ConnorSawaya/SightSense/docs/README.md

# Docs

| Document | What it covers |
| --- | --- |
| [`../AGENTS.md`](../AGENTS.md) | Context and rules for AI coding assistants: what the project is, what is decided, what exists |
| [`PROJECT_HISTORY.md`](PROJECT_HISTORY.md) | How the plan reached its current shape, and why each change was made |
| [`DISCLOSURE.md`](DISCLOSURE.md) | Tools we used that we did not make, and any work done before the event |
| [`../contracts/MESSAGES.md`](../contracts/MESSAGES.md) | Message formats between the phone, the GX10 and the Pi |
| [`../hardware/`](../hardware/) | Printable parts and wiring |
| [`../hardware/BOM.md`](../hardware/BOM.md) | Bill of materials: everything the cane is built from |
| [`media/`](media/) | The 3D pictures in the main README (CAD renders made after the event), and in `media/photos/` the team's photos from the event |
| [3D model](https://connorsawaya.github.io/SightSense/) | The interactive model and guided tour, on GitHub Pages. It is served from the `gh-pages` branch |
