ConnorSawaya/SightSense/ios-app/README.md

# iPhone app

Captures the camera picture, LiDAR depth and position with ARKit and sends them to the GX10. Also plays beeps and speech, takes voice commands, and looks up walking routes.

Open `SightSense.xcodeproj` in Xcode. No packages to install.

## Run it

1. In Xcode, pick the SightSense target → Signing & Capabilities → choose your team. With a free Apple ID, change the bundle identifier if `com.sightsense.capture` is taken.
2. Plug in the iPhone, pick it as the destination, Run.
3. In Connection, enter the GX10 hostname or address reachable from the phone. For Tailscale, use its MagicDNS name or address; for a local router, use the host shown in the router's device list. The examples in the app are placeholders. Add `:8775` for the cane frame service (for example, `gx10.example.invalid:8775`).

Command line build, without opening Xcode:

```bash
xcodebuild -project SightSense.xcodeproj -scheme SightSense -destination 'generic/platform=iOS' \
  DEVELOPMENT_TEAM=<your team ID> -allowProvisioningUpdates build
```

## Test without the GX10

`tools/fake_gx10.py` stands in for the GX10's frame receiver on port 8765. It checks every frame against [`../contracts/MESSAGES.md`](../contracts/MESSAGES.md), prints rate, sizes and depth numbers once a second, and sends a guidance message every 2 seconds. Standard library only.

```bash
python3 tools/fake_gx10.py --save /tmp/frames   # then connect the app to <laptop IP>:8765
./tools/run_link_test.sh                         # the app's link and frame code on the Mac, against the fake
```

`run_link_test.sh` builds `GX10Link.swift` and `FrameMessage.swift` for the Mac and checks depth conversion, row padding, intrinsics scaling, the message layout, 15 frames a second, guidance received, a voice command sent, and reconnecting after the GX10 drops.

## App icon

The logo is drawn in code (`SightSense/LogoMark.swift`): a cane whose tip sends out rings in the LiDAR view's colours. The app shows it on the top bar and the connect screen. To redraw the app icon after changing it:

```bash
swiftc -parse-as-library tools/render_icon.swift SightSense/LogoMark.swift -o /tmp/render_icon \
  && /tmp/render_icon SightSense/Assets.xcassets/AppIcon.appiconset/AppIcon.png
```

In the Simulator there is no camera or LiDAR: Connect opens the link without sending frames, so guidance, speech and voice can still be tried. Launch with `-autoconnect host:port` to connect straight away.

## Files

| File | What it does |
| --- | --- |
| `Capture.swift` | ARKit session, link and location; what the screen shows |
| `FrameSender.swift` | Picks about 15 frames a second; skips a frame if the last one is still going |
| `FrameEncoder.swift` | ARKit frame → frame message (640-wide JPEG, depth, confidence, scaled intrinsics, pose) |
| `FrameMessage.swift` | The message layout and depth conversion, without ARKit, so it runs on a Mac |
| `GX10Link.swift` | WebSocket to port 8765, reconnects every second until disconnected |
| `Guidance.swift` | Parses guidance; beeps (at most once a second) and speaks (same sentence at most every 2 s). Does not speak while the user is talking; tones still play |
| `Voice.swift` | Hold-to-talk, on-device speech recognition; sends `{"text": ...}`. Also started and stopped by the cane's talk button |
| `Location.swift` | GPS and compass heading for the frame header |
| `Places.swift` | Looks a place up with Apple Maps and sends the walking route to it. Not compiled yet |

## The cane's talk button

A push button in the cane's handle does the same job as the talk button on the screen. The Pi reports it to the GX10, and the GX10 sends the phone `{"listen": true}` or `{"listen": false}` ([`../contracts/MESSAGES.md`](../contracts/MESSAGES.md)).

- `true` plays a short tone and starts listening. If the phone is already listening it stops instead, so a second click ends a command.
- `false` stops listening and sends what was heard. It comes when the button is let go after a hold.
- After a click, with no `false`, the phone stops by itself 1.5 seconds after the last new word, or after 8 seconds if it heard nothing, and in any case about 12 seconds after it started.
- A click in the 2 seconds after the phone has stopped by itself with something heard is taken as the end of that command. It plays the tone but does not start another. If the phone heard nothing, the click starts a new listen.
- While the phone is listening, from either button, it does not speak. Tones still play, the stop tone among them.

Sound, speech and touch, all written October 11 and not built yet:

- A turn can be felt as well as heard: a light tap for left and a heavy one for right, beside the stop warning that was already there.
- Settings has a **Test sounds and speech** button. It plays each tone and says its name, with no GX10 needed.
- Saying "sound check" (or typing it in Settings or on the dashboard) makes the GX10 send each tone with its name, which checks the whole path.
- The app says "Connected" when the link opens and "Connection lost" with the stop tone when it drops, as before.

**Not built yet.** This was written on a Windows laptop with no Xcode. It has not been compiled or run on a phone. Every Swift file in the app parses with a Swift grammar (tree-sitter, October 11), which rules out syntax errors only: types, names and the Apple frameworks are checked by the compiler alone. Build it and try both buttons before relying on it.

## Build order

Steps 1–7 are written. Step 8 is written in `Places.swift` but has not been compiled or run: it was written on a Windows laptop with no Xcode.

1. App shell: GX10 address field, Connect button, status line, screen kept awake.
2. ARKit session with scene depth on; show the tracking state.
3. WebSocket to `ws://<GX10>:8765` with automatic reconnect.
4. Send the frame message from [`../contracts/MESSAGES.md`](../contracts/MESSAGES.md) about 15 times a second.
5. Receive guidance: beep on STOP, speak the `speech` text.
6. Push-to-talk with on-device speech recognition; send `{"text": "..."}`.
7. Location and compass heading in every frame header.
8. Place lookup with MapKit walking directions; send the route message.

How step 8 works: the GX10 sends `{"lookup": "Safeway"}`. The phone searches Apple Maps within 5 km of where it is and takes the nearest result, so "a coffee shop" means the nearest one. It asks for walking directions and sends the route message. If it finds no place or no route it sends an empty route, and the GX10 says so. The GX10 then says the name, the distance and the time, and waits for "yes".

Step 4 is the one everything else depends on.

## Watch out for

- ARKit's picture and depth are in the sensor's landscape direction. If the phone is mounted upright, the data arrives turned 90 degrees.
- Skip a frame if the previous send has not finished. Never queue frames.
- Scale the camera intrinsics to the depth picture's size.
- Info.plist needs usage descriptions for the camera, microphone, speech recognition, location and local network, plus `NSAllowsArbitraryLoads` for `ws://` to the GX10's Tailscale address (100.x is not "local" to iOS, and `NSAllowsLocalNetworking` alongside it would cancel it).
