ConnorSawaya/SightSense/docs/media/photos/team-nametags.jpg

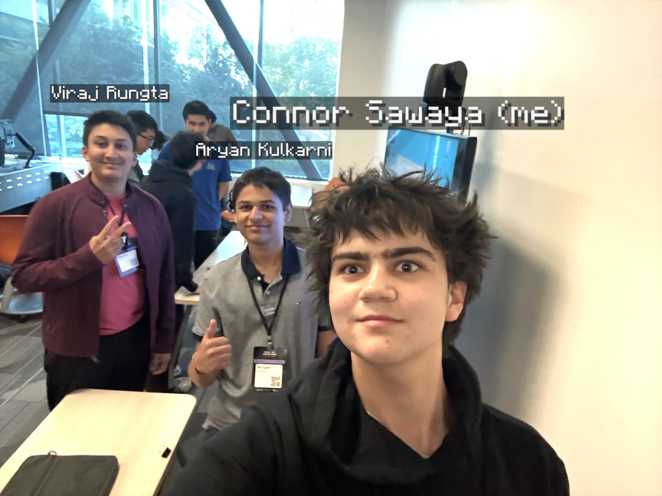
docs/media/photos/team-nametags.jpg
