ConnorSawaya/SightSense/hardware/cane-coupler/PathSense_MotorReceiver_v4_preview.png

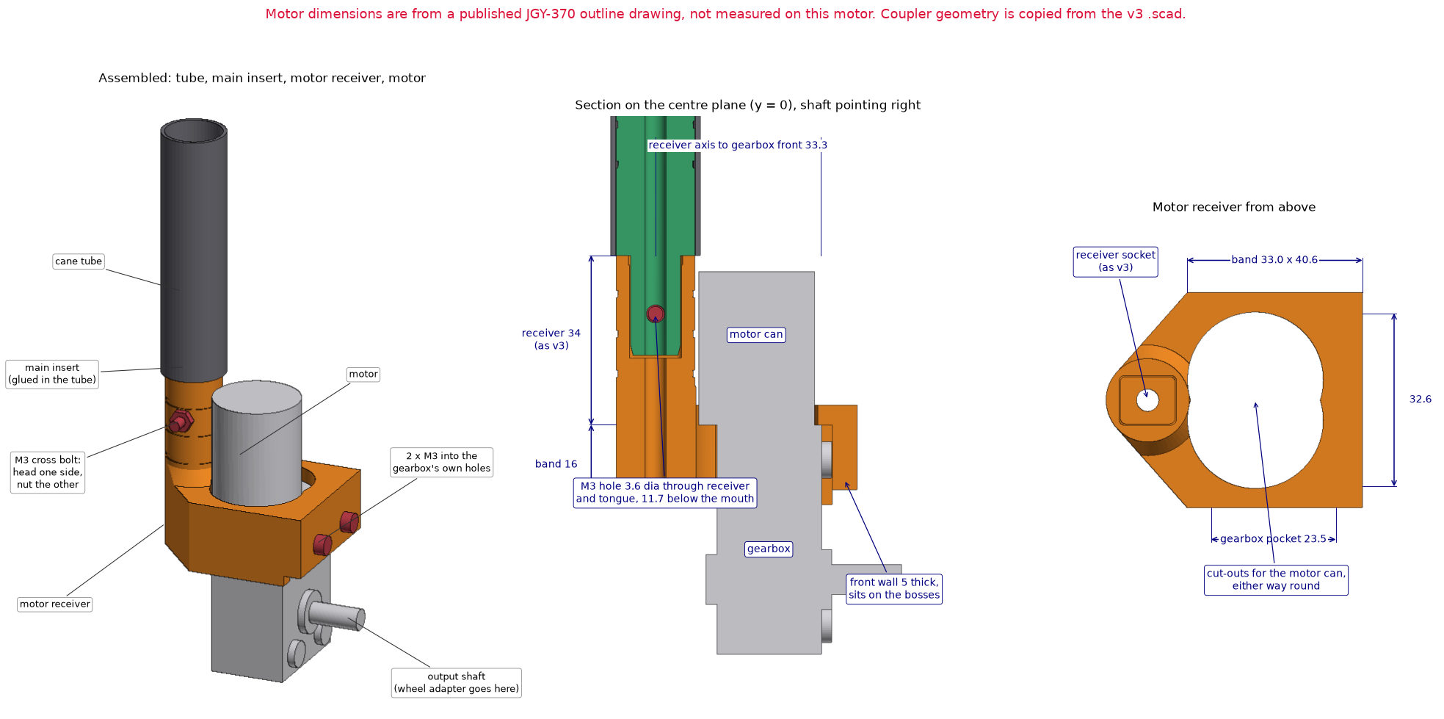
hardware/cane-coupler/PathSense_MotorReceiver_v4_preview.png
