ConnorSawaya/SightSense/hardware/handle-phone-mount/previews/2_side_view_tilt.png

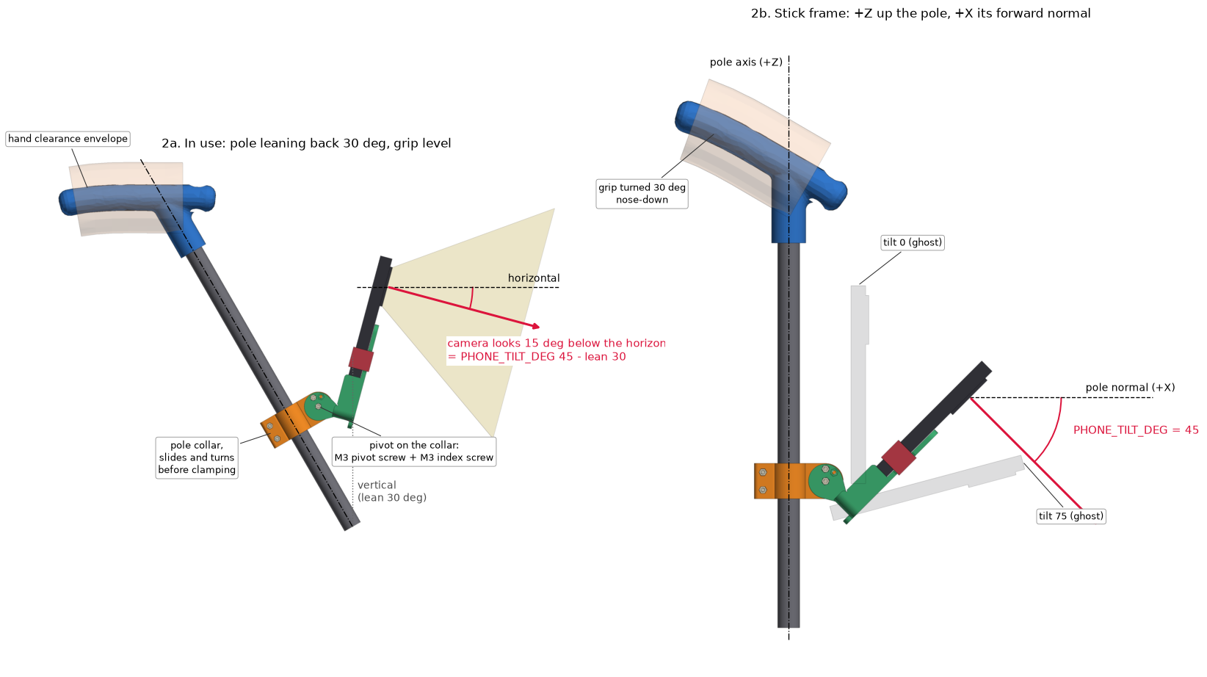
hardware/handle-phone-mount/previews/2_side_view_tilt.png
