ConnorSawaya/SightSense/hardware/handle-phone-mount/previews/3_front_view_retention.png

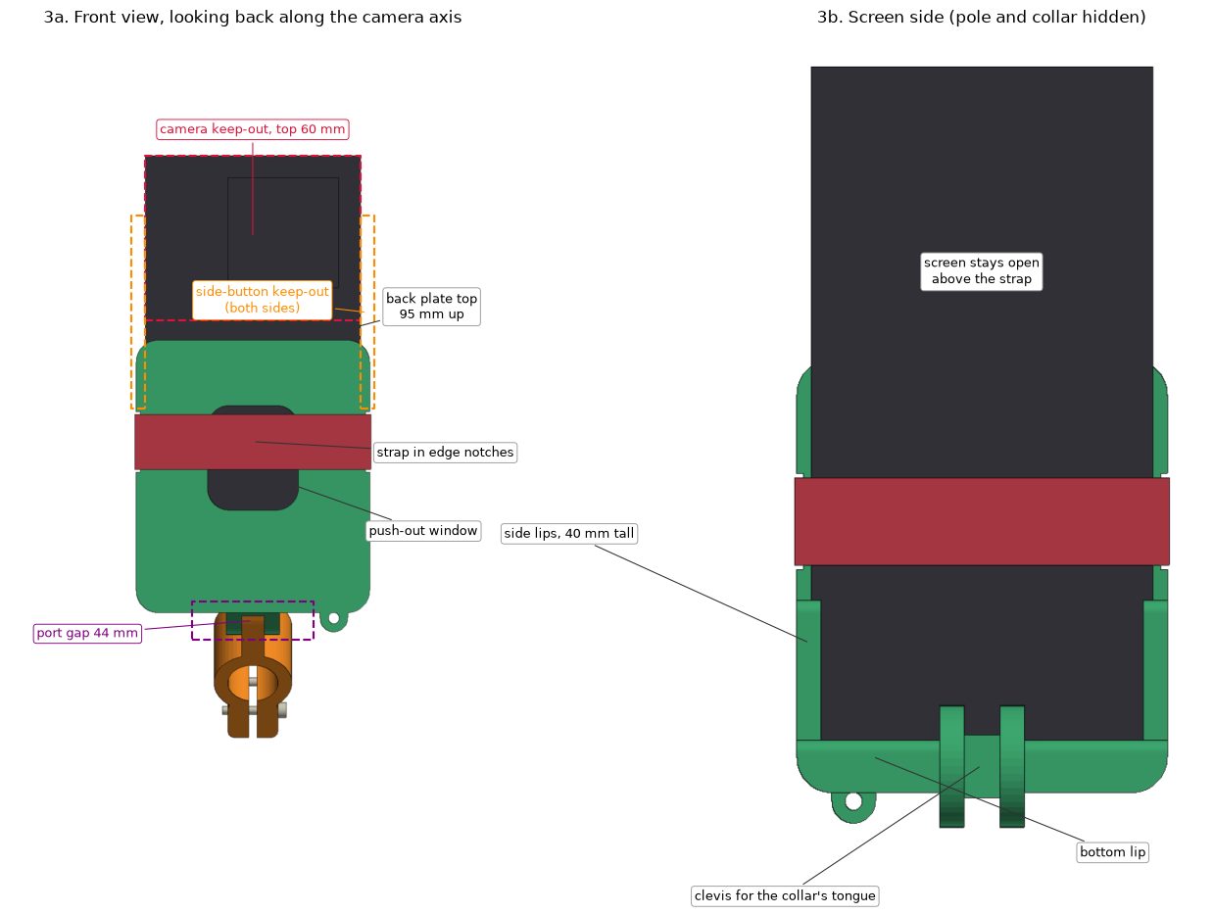
hardware/handle-phone-mount/previews/3_front_view_retention.png
