ConnorSawaya/SightSense/hardware/handle-phone-mount/previews/4_exploded.png

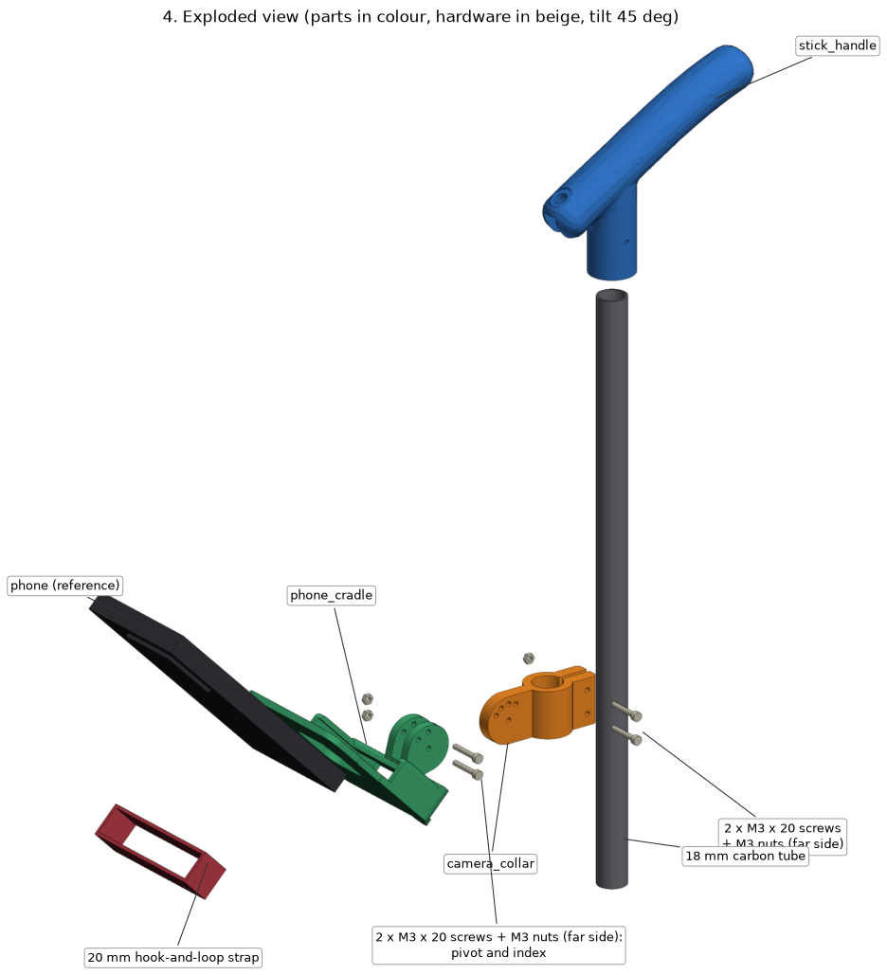
hardware/handle-phone-mount/previews/4_exploded.png
