ConnorSawaya/SightSense/hardware/handle-phone-mount/previews/5_sections_joint.png

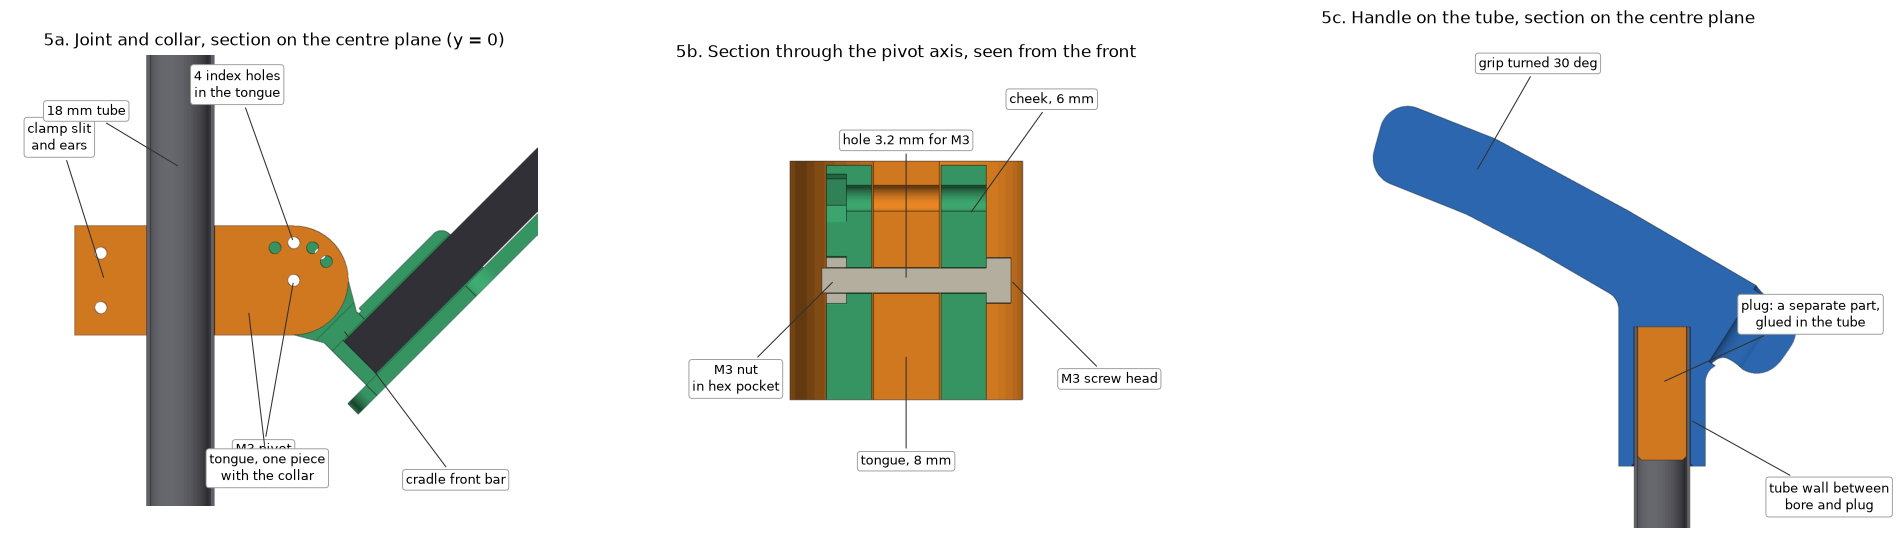
hardware/handle-phone-mount/previews/5_sections_joint.png
