ConnorSawaya/SightSense/hardware/handle-phone-mount/previews/7_dimensions_handle.png

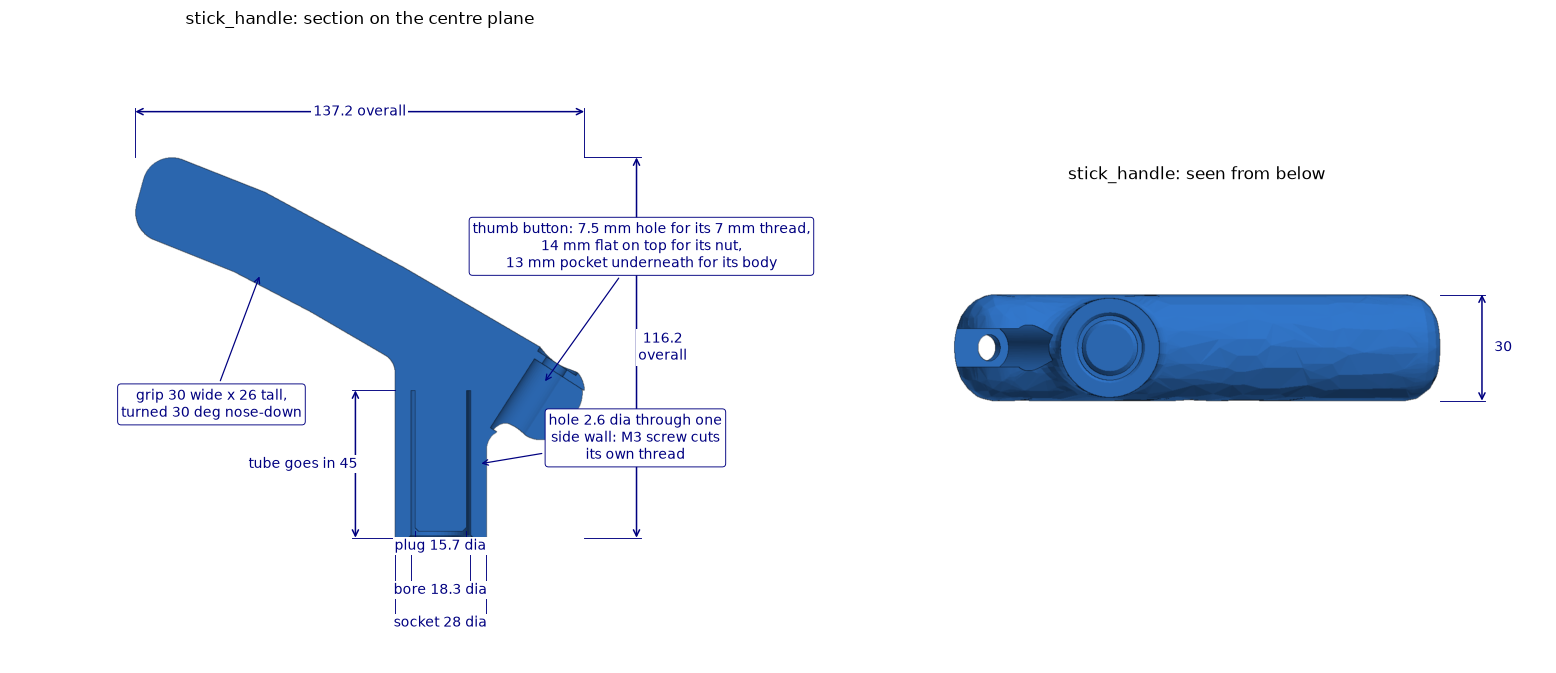
hardware/handle-phone-mount/previews/7_dimensions_handle.png
