ConnorSawaya/SightSense/hardware/handle-phone-mount/previews/8_dimensions_collar.png

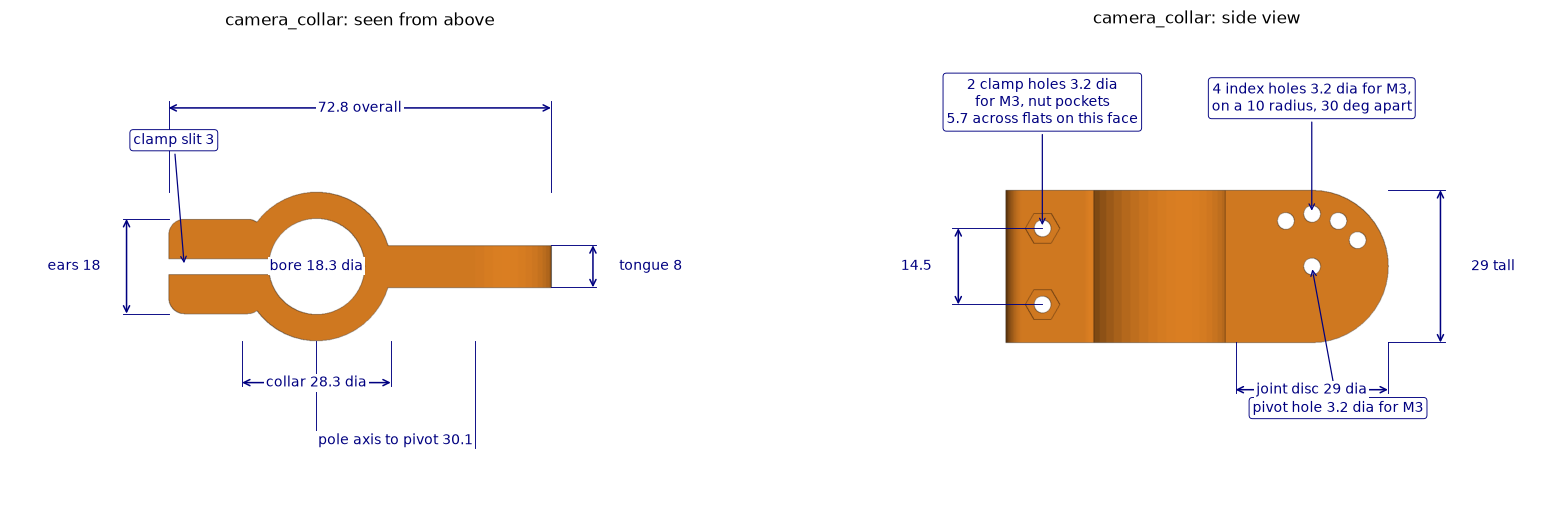
hardware/handle-phone-mount/previews/8_dimensions_collar.png
