ConnorSawaya/SightSense/hardware/handle-phone-mount/previews/9_dimensions_cradle.png

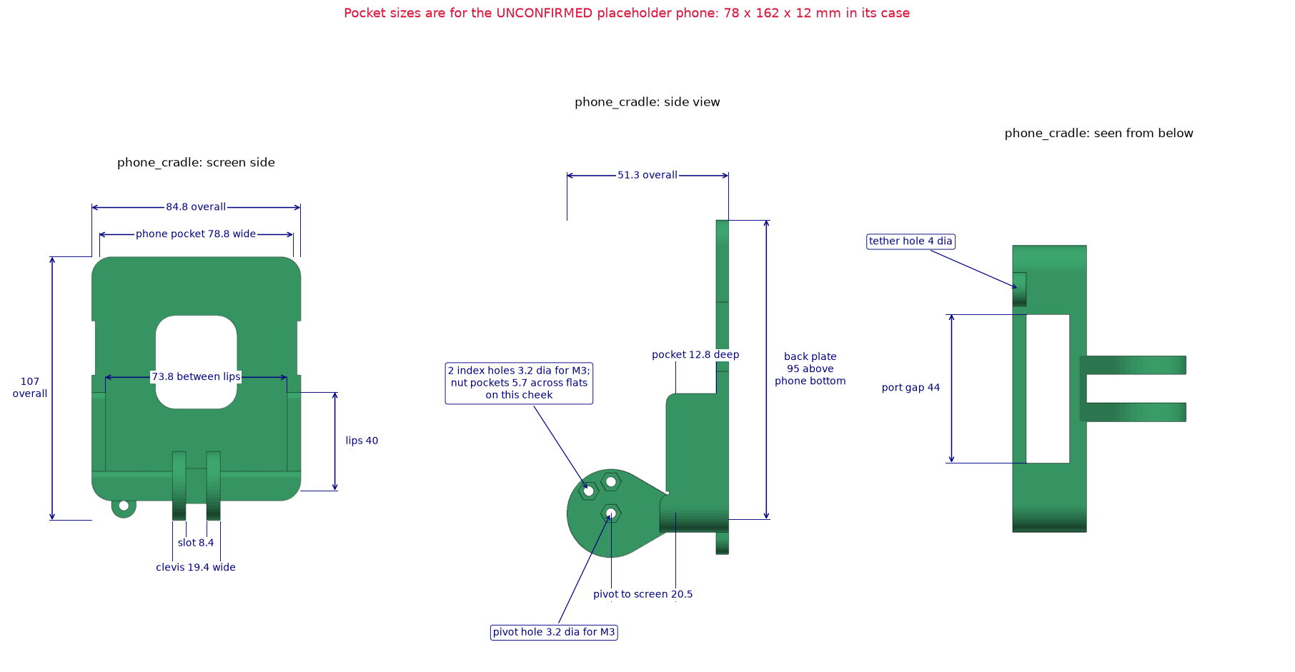
hardware/handle-phone-mount/previews/9_dimensions_cradle.png
