ConnorSawaya/SightSense/hardware/handle-phone-mount/export/assembly.step

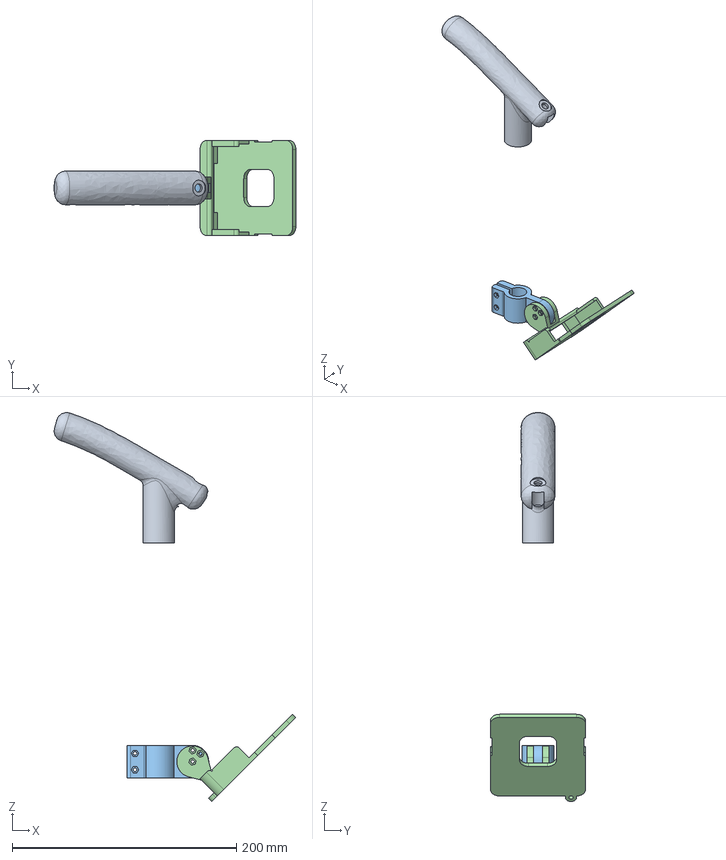
[picture p18: CAD file, 2026-10-11]
hardware/handle-phone-mount/export/assembly.step
215.6 x 84.8 x 346.8 mm
stick_handle
socket_plug
camera_collar
phone_cradle
