ConnorSawaya/SightSense/hardware/cane-coupler/PathSense_Keyed_ShockCord_Main_v3.stl

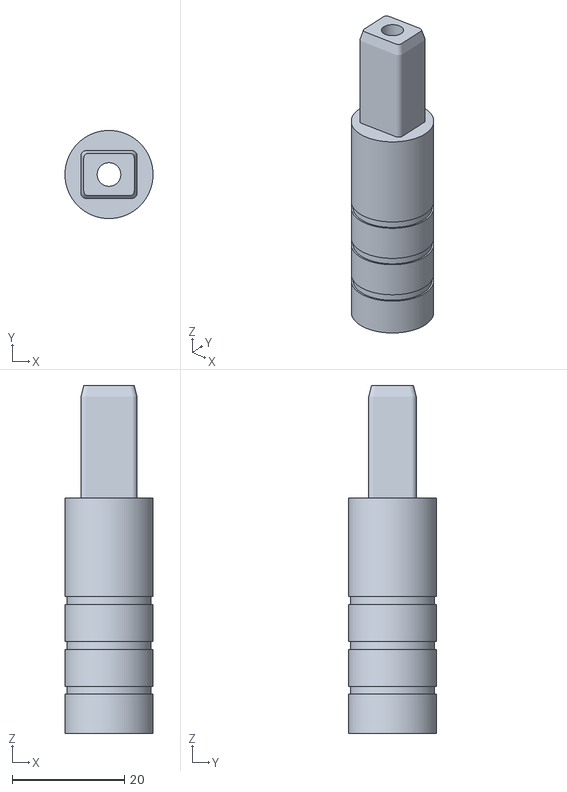
[picture p19: CAD file, 2026-10-10]
hardware/cane-coupler/PathSense_Keyed_ShockCord_Main_v3.stl
15.7 x 15.7 x 62.0
