ConnorSawaya/SightSense/hardware/cane-coupler/PathSense_Keyed_ShockCord_MotorReceiver_v4.step

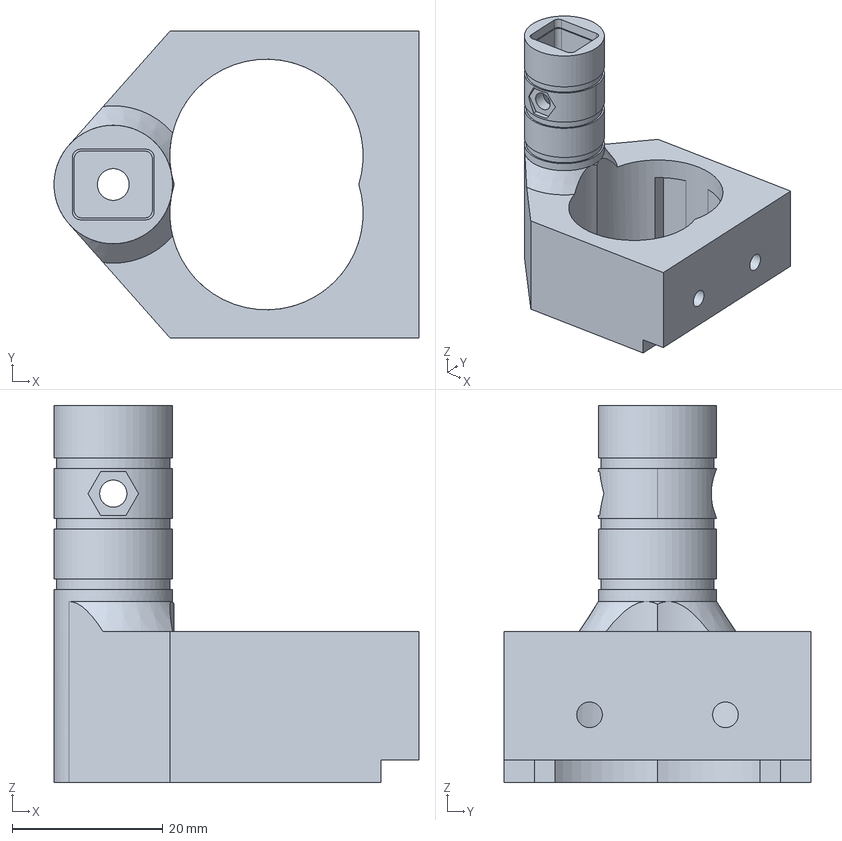
[picture p20: CAD file, 2026-10-11]
hardware/cane-coupler/PathSense_Keyed_ShockCord_MotorReceiver_v4.step
48.3 x 40.6 x 50.0 mm
