ConnorSawaya/SightSense/hardware/electronics-mount/export/electronics_mount_pi_half.step

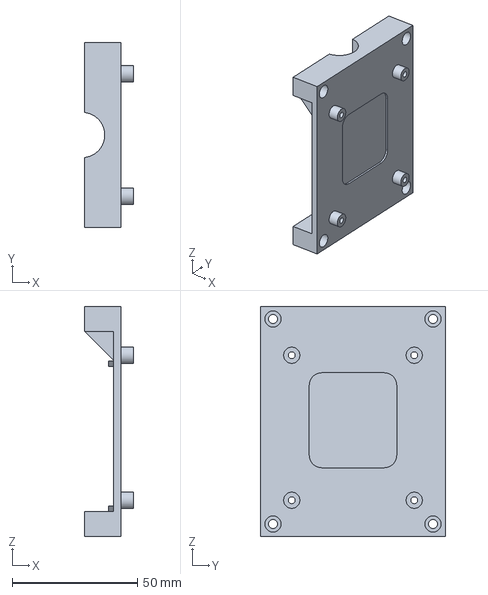
[picture p21: CAD file, 2026-10-11]
hardware/electronics-mount/export/electronics_mount_pi_half.step
19.5 x 74.0 x 92.0 mm
