ConnorSawaya/SightSense/hardware/motor-mount-2/export/motor_mount_2_motor_fit_test.step

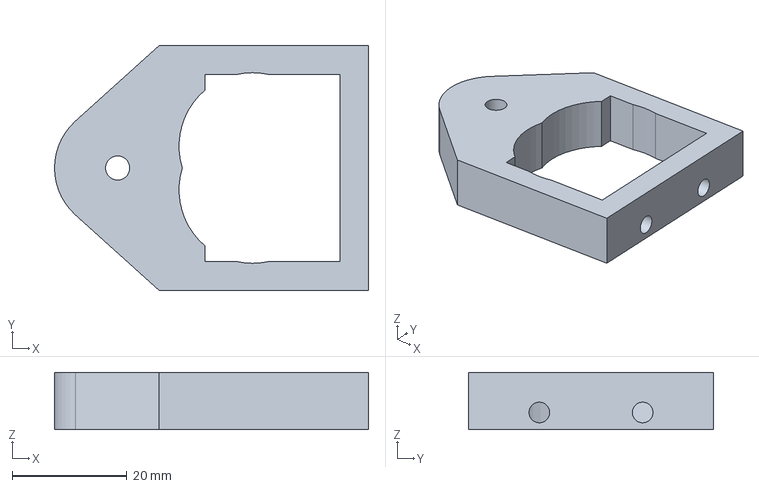
[picture p22: CAD file, 2026-10-11]
hardware/motor-mount-2/export/motor_mount_2_motor_fit_test.step
54.7 x 42.6 x 10.0 mm
