ConnorSawaya/SightSense/hardware/wheel-adapter/export/wheel_cap.stl

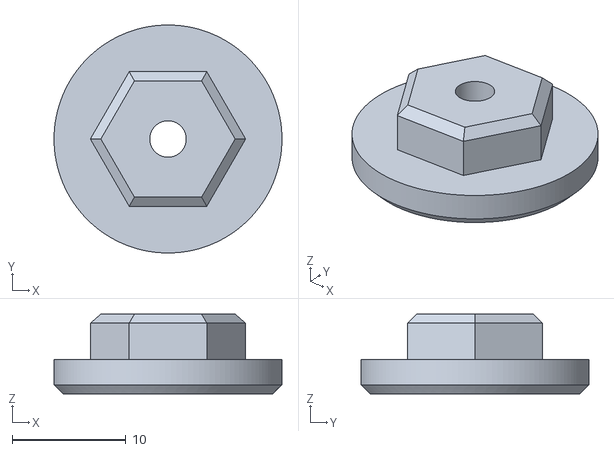
[picture p23: CAD file, 2026-10-10]
hardware/wheel-adapter/export/wheel_cap.stl
20.0 x 20.0 x 7.00
