ConnorSawaya/SightSense/hardware/cane-coupler/PathSense_Keyed_ShockCord_Receiver_v3.stl

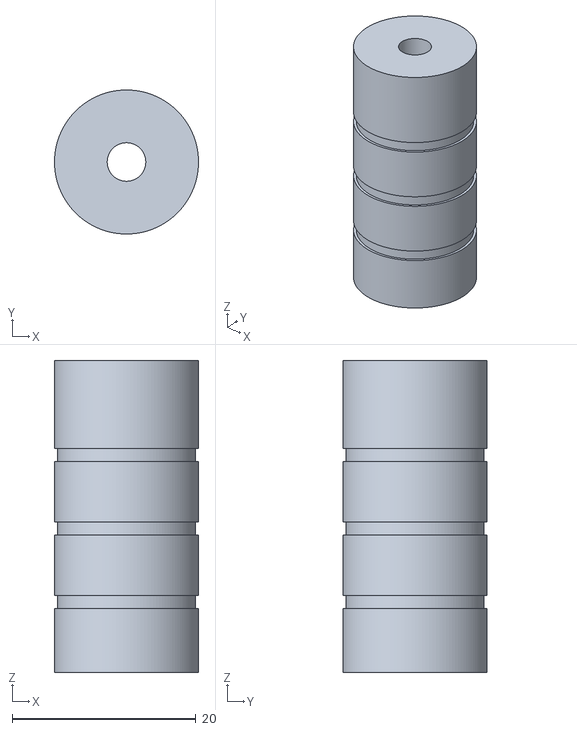
[picture p24: CAD file, 2026-10-10]
hardware/cane-coupler/PathSense_Keyed_ShockCord_Receiver_v3.stl
15.7 x 15.7 x 34.0
