ConnorSawaya/SightSense/hardware/handle-phone-mount/export/stick_handle.step

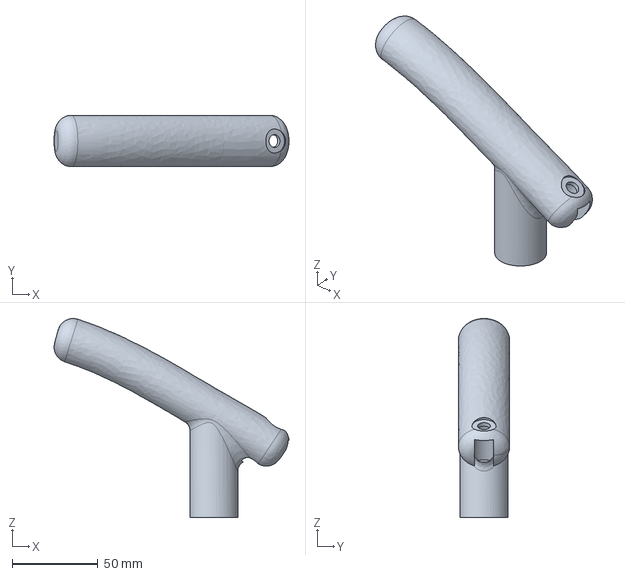
[picture p25: CAD file, 2026-10-11]
hardware/handle-phone-mount/export/stick_handle.step
137.2 x 30.0 x 116.2 mm
