ConnorSawaya/SightSense/hardware/motor-mount-2/export/motor_mount_2.stl

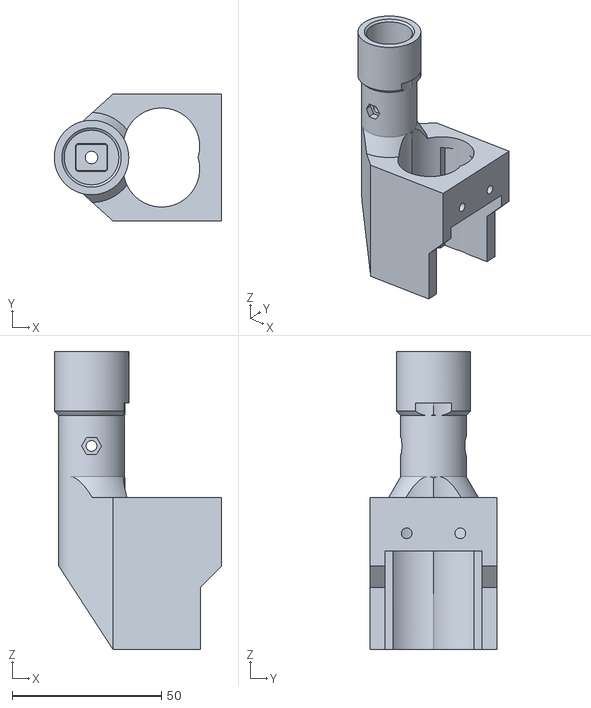
[picture p26: CAD file, 2026-10-11]
hardware/motor-mount-2/export/motor_mount_2.stl
56.2 x 42.6 x 100.0
