ConnorSawaya/SightSense/hardware/wheel-adapter/export/wheel_adapter.step

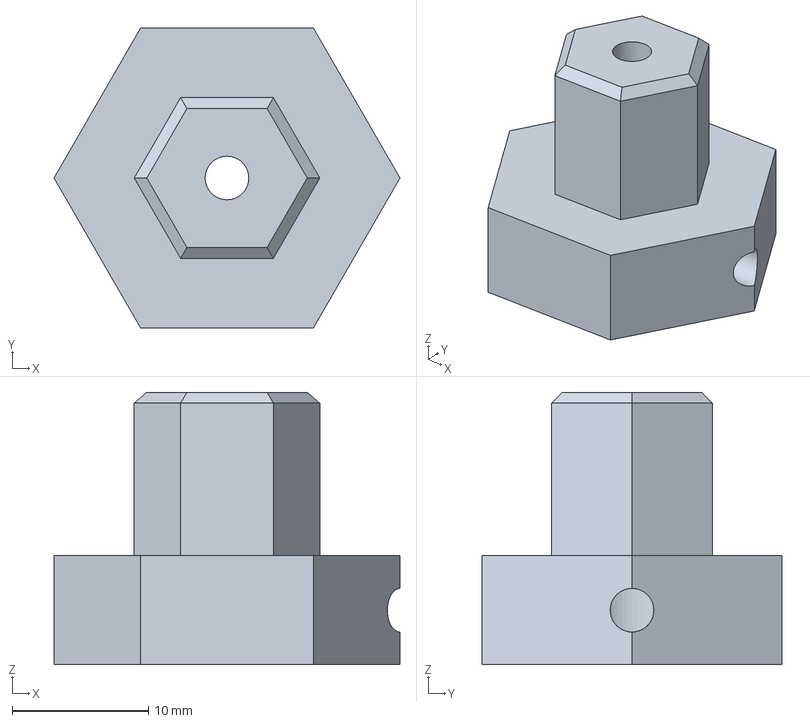
[picture p27: CAD file, 2026-10-10]
hardware/wheel-adapter/export/wheel_adapter.step
25.4 x 22.0 x 20.0 mm
