ConnorSawaya/SightSense/hardware/handle-phone-mount/export/cradle_fit_test.step

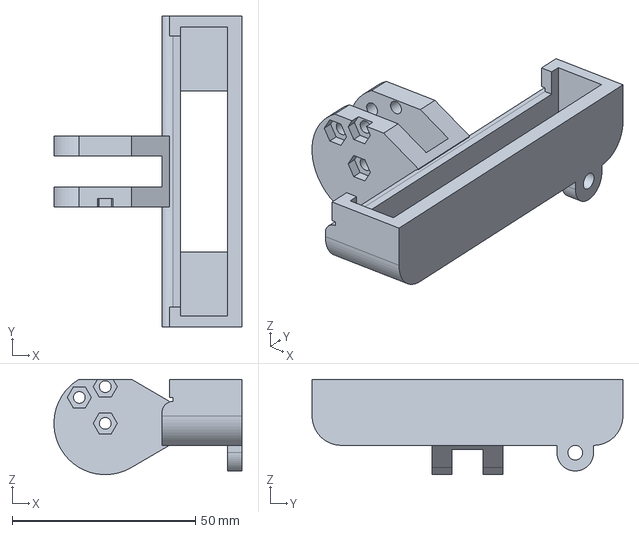
[picture p28: CAD file, 2026-10-10]
hardware/handle-phone-mount/export/cradle_fit_test.step
51.3 x 84.8 x 26.0 mm
