ConnorSawaya/SightSense/hardware/wheel-adapter/export/wheel_adapter_fit_test.step

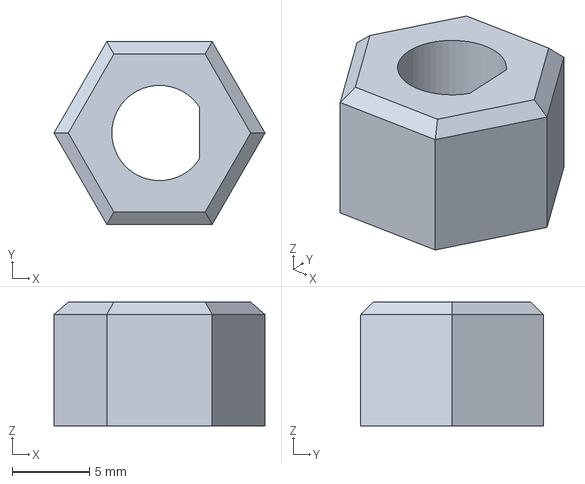
[picture p29: CAD file, 2026-10-10]
hardware/wheel-adapter/export/wheel_adapter_fit_test.step
13.6 x 11.8 x 8.00 mm
