ConnorSawaya/SightSense/hardware/handle-phone-mount/export/camera_collar.step

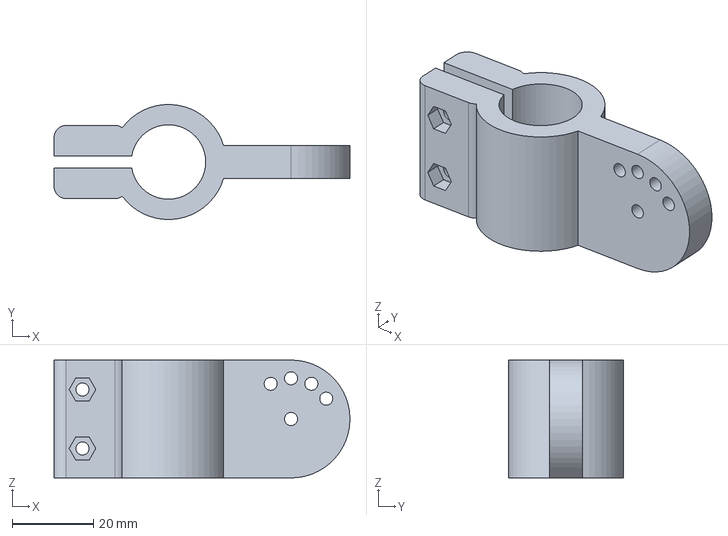
[picture p30: CAD file, 2026-10-10]
hardware/handle-phone-mount/export/camera_collar.step
72.8 x 28.3 x 29.0 mm
