ConnorSawaya/SightSense/hardware/handle-phone-mount/export/phone_cradle.step

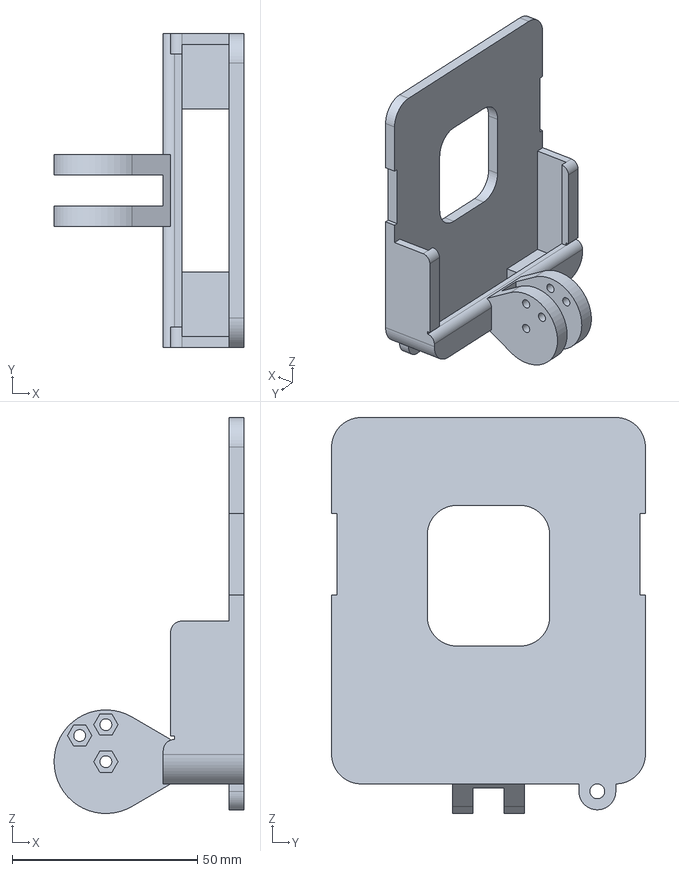
[picture p31: CAD file, 2026-10-10]
hardware/handle-phone-mount/export/phone_cradle.step
51.3 x 84.8 x 107.0 mm
