ConnorSawaya/SightSense/hardware/handle-phone-mount/export/handle_fit_test.step

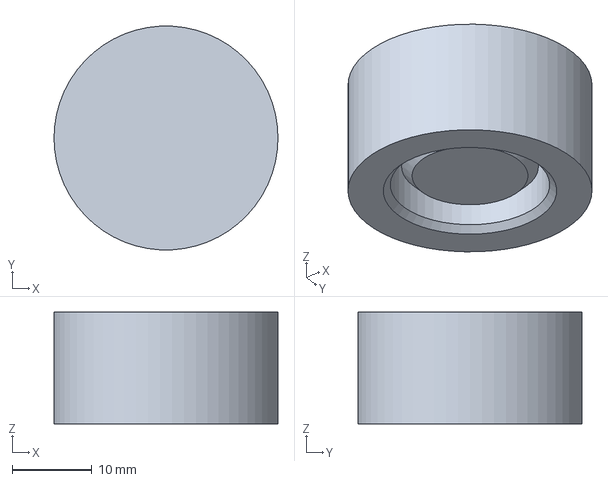
[picture p32: CAD file, 2026-10-10]
hardware/handle-phone-mount/export/handle_fit_test.step
28.0 x 28.0 x 14.0 mm
