ConnorSawaya/SightSense/(list of files, cad)

Other CAD files:
hardware/cane-coupler/PathSense_Keyed_ShockCord_MotorReceiver_v4.stl
hardware/electronics-mount/export/electronics_mount_pi_half.stl
hardware/handle-phone-mount/export/camera_collar.stl
hardware/handle-phone-mount/export/cradle_fit_test.stl
hardware/handle-phone-mount/export/handle_fit_test.stl
hardware/handle-phone-mount/export/phone_cradle.stl
hardware/handle-phone-mount/export/stick_handle.stl
hardware/wheel-adapter/export/wheel_adapter.stl
hardware/wheel-adapter/export/wheel_adapter_fit_test.stl
