ConnorSawaya/SightSense/hardware/assembly/assembly_viewer.html

# SightSense cane assembly

Zoom +Zoom −Lean pole: on

Parts

Printed parts onlyShow all

About this model

Tube drawn 900 mm long; it is cut to suit the user. The wheel and the phone are stand-ins: their sizes are not measured. Motor sizes are from a published drawing. Research prototype: nothing here has been printed or load tested.

Drag to rotate · scroll to zoom · right-drag or Shift-drag to pan
