ConnorSawaya/SightSense/hardware/handle-phone-mount/previews/6_print_orientations.png

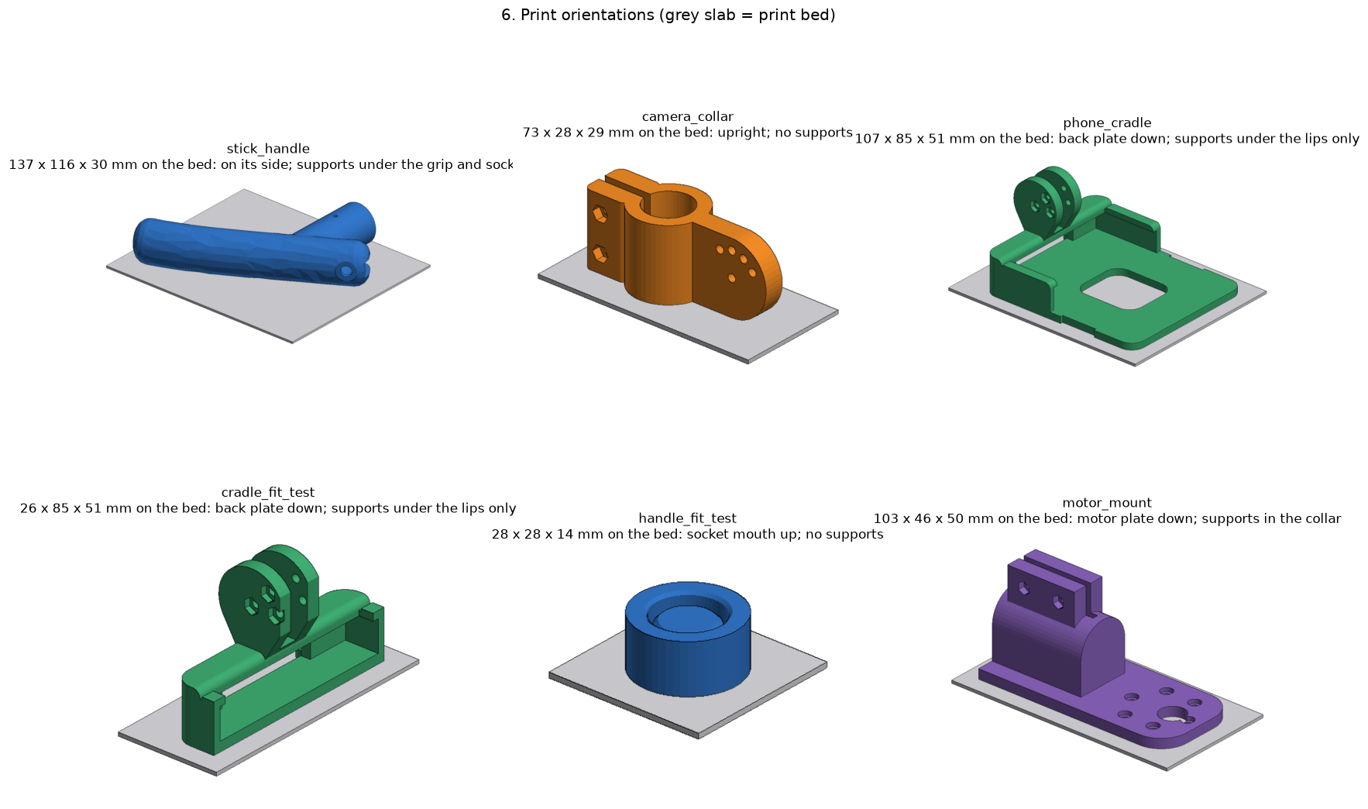
hardware/handle-phone-mount/previews/6_print_orientations.png
