ConnorSawaya/SightSense/(commit log)

2026-10-10 Add cane coupler files and set up the repo structure
    Add the keyed shock-cord coupler for the 18 mm carbon-fibre tube cane
    (two STL parts and the OpenSCAD source) under hardware/cane-coupler,
    with a README giving its dimensions, print notes and assembly steps.
    Lay out the repository: contracts (message formats), ios-app, gx10, pi,
    hardware (wiring and part conventions) and docs (handbook link and a
    disclosure file). Each folder has a README describing what goes there.
2026-10-10 Add project context and history for AI assistants
    AGENTS.md gives an AI coding assistant what it needs before touching
    the repo: what the project is, current status, the rules that must not
    be broken, machines and addresses, decisions made, the algorithms with
    their starting numbers, known traps, priorities and checkpoints.
    CLAUDE.md imports it so Claude Code loads it automatically.
    docs/PROJECT_HISTORY.md records how the plan changed and why, from the
    first wearable idea to the cane, including ideas that were dropped.
2026-10-10 Add tilted handle and pole-mounted phone mount
    New hardware/handle-phone-mount folder: build123d source, STL and STEP
    exports for the handle, pole collar and phone cradle, two fit-test
    pieces, review images and a 3D viewer page.
    The cradle is sized for a placeholder phone and is not ready to print.
    Geometric checks only; nothing has been printed or load tested.
    docs/DISCLOSURE.md records that the script was started about an hour
    before hacking opened.
2026-10-10 Note that the oversize phone cradle is intentional and strapped
    The team will print the cradle at its generic phone size and hold the
    iPhone with straps, so the docs no longer say it is not ready to print.
2026-10-10 Add the Pi motor controller, tested on a simulated wheel
    The steering rules from pi/README.md: three positions found with limit
    switches, 25% power cap, 0.4 s limit per move, driver off after 0.4 s
    without a command, home to centre at start and after the driver has been
    off.
    It can take commands from the GX10's WebSocket port, from the keyboard,
    or from fake_gx10.py, and can run on a simulated wheel with no GPIO.
    Tested on a laptop only: 29 unit tests on the simulated wheel and
    gpiozero's mock pins, plus live runs with typed commands and with the
    fake GX10. Not yet run on the Pi or with a real motor.
    Adds one dependency on the Pi: python3-websockets.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
2026-10-10 Add printed wheel adapter for the JGY-370 D-shaft
    New hardware/wheel-adapter folder: build123d source, STL and STEP
    exports, a fit-test piece and a dimensioned drawing. The hub puts the
    omni wheel's hex socket onto the gearmotor's 6 mm D-shaft.
    The hex size, shaft flat and shaft length are estimates, so the README
    says to print the fit test first. Geometric checks only; nothing has
    been printed or load tested.
2026-10-10 Add the navigator: voice commands, guide to an object, route follower
    gx10/navigator/ turns voice text into commands, guides to an object found
    by vlm.find (distance from the LiDAR depth in the box, target kept as an
    ARKit world point), and follows a MapKit route from GPS and heading. It
    only outputs a desired bearing; the obstacle check decides what is clear.
    Standard library only. 25 tests on fake frames; live check with
    qwen3.6:35b passes on the test pictures. Also defaults vlm to
    qwen3.6:35b while Qwen3-VL downloads.
2026-10-10 Add the YOLO detector and feed its boxes to the object guide
    gx10/detector/ runs YOLO26s with PyTorch in a project-folder virtual
    environment (Docker needs a group change on the borrowed GX10). 5.9 ms a
    frame including JPEG decode; finds the bus, people and apples in the test
    pictures and nothing in the empty room. navigator.check_live --yolo
    confirms the apple in 0.09 s instead of 1.3-1.8 s. TensorRT export is
    written but not run. Weights are not committed (*.pt is ignored).
2026-10-10 Add the iPhone app: LiDAR capture, frame sending, guidance, voice, location
    SwiftUI + ARKit app in ios-app/ following contracts/MESSAGES.md. Shows LiDAR
    depth only; the camera JPEG is still sent for the vision-language model.
    Tracking words match gx10/navigator (notAvailable, relocalizing).
    tools/fake_gx10.py checks frames against the contract and sends test guidance;
    tools/run_link_test.sh runs the app's link and message code on a Mac against it.
    Tested on a Mac, in the Simulator, and installed on an iPhone 15 Pro.
2026-10-10 Record the first run of the motor controller on the Pi
    On the Raspberry Pi 5 (Raspberry Pi OS Lite 64-bit, 2026-10-06): the 29
    unit tests pass, the simulated wheel follows typed commands, and the
    real GPIO pins open with the switches reading "none pressed". No motor
    or switches were connected, so nothing was driven.
2026-10-10 Rework the wheel adapter for the measured wheel
    The hub now has a 12 mm hex and a 10 mm round pilot, both from the
    team's measurements of the wheel. The wheel screw's nut moved to the
    far side of the wheel, where it can be reached, and a printed cap was
    added for it to tighten against. No slot is cut into the hex any more.
    The bore is round where the shaft has no flat. Shaft sizes are checked
    against a published JGY-370 outline drawing, not measured on the motor.
2026-10-10 Add v4 coupler parts: M3 cross bolt and motor receiver
    The v4 main insert and receiver keep the v3 coupler geometry (rebuilt
    from the .scad; volumes agree with the v3 STLs to within 0.06%) and
    gain one M3 hole through the receiver and the tongue.
    The v4 receiver also stands on a band that holds the JGY-370 gearmotor
    beside it, fixed with two M3 screws into the gearbox's own holes.
    Motor sizes come from a published outline drawing, not from measuring
    this motor. Geometric checks only; nothing has been printed.
    The v3 files are unchanged.
2026-10-10 Allow ws:// to the GX10's Tailscale address; show full link errors
    iOS does not count 100.x Tailscale addresses as local, so NSAllowsLocalNetworking
    blocked the WebSocket. Tested: real iPhone 15 Pro frames reach the GX10 over Tailscale.
2026-10-10 Add a first frame service and obstacle check
    gx10/ingest/server.py takes the phone frames on 8765 (newest only), turns
    the picture upright from the pose for YOLO and the vision model, runs the
    navigator and the 7-heading obstacle check from AGENTS.md, and sends
    guidance to the phone and a command to the Pi on 8766 every frame.
    gx10/planner/ is the depth-only obstacle check with numpy; unknown and
    too-close readings count as blocked. Tested on ray-cast scenes and a fake
    phone walking at a wall: 15 fps, 10 ms on the GX10, STOP at 2.27 m.
    First versions, to get the loop going before the 5 PM checkpoint.
2026-10-10 Redesign the iPhone app: full-screen LiDAR HUD with Liquid Glass
    - LiDAR viewport with reticle and large centre distance over a blurred depth backdrop
    - Guidance pill tinted by state; red edge glow and haptic on STOP
    - Glass dock: hold to talk, Describe and Read quick commands for gx10/navigator
    - Settings sheet from the top-left gear: address, presets (Tailscale, team router),
    recent addresses, connect/disconnect, full link status and diagnostics, typed commands
    - Microphone and speech permission asked on first use, not at launch
    - Minimum iOS 26 for Liquid Glass; Simulator shows a synthetic depth scene
2026-10-10 Add the dashboard and the network round trip
    gx10/dashboard/ serves a page on port 8000 from the frame service: the
    upright picture with YOLO boxes, colour depth, the command and state,
    clearance per heading, a text box that works like a voice command,
    frames per second, GX10 time, WebSocket round trip, GPU use. Checked in a
    browser over Tailscale with the fake phone running.
2026-10-10 Document the wiring by header pin, the Pi's set-up and the network change
    - hardware/wiring.md: header pin numbers, how to find them, which switch
    legs to use, the order to wire in, and what damages the Pi.
    - pi/README.md: the team's Pi (OS, bootloader, login, what is installed),
    power and fan notes, and how its bootloader error was fixed.
    - docs/PROJECT_HISTORY.md: no router at the venue, venue Wi-Fi problems,
    the phone hotspot, and the Pi's first start.
    - AGENTS.md: the Pi's real network, and three new known traps.
    - docs/DISCLOSURE.md: Raspberry Pi OS, Imager and the bootloader recovery
    files; the SD card was written the evening before the event.
    Nothing in the wiring has been bu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
2026-10-11 Switch the wiring and the controller to the IBT-2 driver the team has
    The motor driver is an IBT-2 (BTS7960) board, not the L298N the plan
    assumed. It takes two enable pins and a PWM pin for each direction.
    - pi/hardware.py: enables on GPIO18 and GPIO25, power on GPIO23 (RPWM)
    or GPIO24 (LPWM). Driver off is both enables low and no PWM.
    - pi/test_steering.py: pin tests for the new pin set, and a check that
    both directions are never powered together. 30 tests.
    - hardware/wiring.md: the real parts, the power split at the screw
    adapter, the converter that powers the Pi, and the header pins.
    - AGENTS.md, README.md, hardware/README.md, pi/README.md,
    docs/PROJECT_HISTORY.md: L298N replace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
2026-10-11 Cut the app's heat: 30 fps camera, lower send rate when hot, lighter screen
    The phone reached thermal state 'serious' within minutes of streaming.
    - ARKit ran at its default 60 fps although only 15 frames a second are sent; pick
    the lowest-rate 4:3 format (30 fps) so the camera, LiDAR and tracking do half the work
    - Send 15 fps normally, 8 when 'serious', 4 when 'critical'; the screen says so
    - JPEG quality 0.6 -> 0.4 (pictures were ~67 KB)
    - Depth preview 5 pictures a second (2 when hot) instead of 10
    - Static backdrop instead of a live full-screen blur of the depth picture
    - Settings show the camera format and the phone's heat
2026-10-11 Hold the phone's guidance state steady instead of flickering
    Holding the iPhone still about 2.5 m from something flipped CLEAR/CAUTION every few
    frames: the state was worked out fresh each frame against USABLE_M, and each flip
    replayed the caution earcon. planner/state.py adds hysteresis (back to CLEAR only past
    2.8 m, for 5 frames) and a 2-frame hold for other changes. STOP is never delayed.
    Tested: planner.test_state (9 new), all 55 gx10 unit tests, and ingest.fake_phone's
    wall walk on spare ports on the GX10 (STOP at the same frame and distance as before).
2026-10-11 Revise the wheel adapter after the first test print
    The first print's 3.2 mm holes were too tight for M3 screws and the
    motor bore did not fit well. The model also had a fault: the bore's
    flat ran to the bottom, so the wheel screw's head could not sit
    centred there.
    - Screw holes are 3.6 mm.
    - The bore follows the published shaft drawing and is D-shaped from
    its mouth, with a round pocket and passage for the wheel screw's
    head. The adapter now starts where the shaft's flat starts.
    - The collar is 28 mm across flats, with the clamp screw's head sunk
    into it.
    - The nut slot is 3.2 mm thick and sits 3.75 mm out from the bore,
    with a flat wall between them.
    - Parts are exported standing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
2026-10-11 Let Qwen understand voice commands the rules miss; answer status and questions
    Rules in navigator/commands.py stay first (instant). A sentence they do not understand
    goes to vlm.interpret(), text only, which picks one of the same commands or:
    - status ('am I going the right way', 'how far is it'): answered from the navigator's
    own numbers, never by the model; the common phrasings are also a rule now
    - question: answered from the picture by vlm.ask(), told never to give distances or say
    whether it is safe; any distance in the reply is replaced
    The model never steers. 'Am I going the right way' had come back 'unknown' three times
    in the iPhone test on October 10.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
2026-10-11 Hold CLEAR back for 1 s and judge by the nearest reading of the last half second
    On the October 10 walk the reading ahead jumped between about 2.2 and 4.5 m from frame
    to frame, and with a 5-frame hold the phone still flipped CLEAR/CAUTION five times in
    4 s. Never slower to say CAUTION or STOP; only slower to say CLEAR.
2026-10-11 Answer "am I going the right way", path questions and free questions
    The first iPhone test said "Am I going the right way" three times and got
    "didn't catch that". Now:
    - status ("am I going the right way", "how far is it", "which way"):
    the navigator says the direction and LiDAR distance to the object, or
    on/off the route and metres to go;
    - path ("is the path clear", "is it safe", "anything in front of me"):
    answered by the frame service from this frame's obstacle check only,
    never the model, and never called safe;
    - any other question goes to vlm.ask, told not to give distances or judge
    safety; a sentence with a distance in it is dropped;
    - anything else gets a hint listing comm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
2026-10-11 Pass the model's voice understanding through the frame service; ask with the whole sentence
    - ingest.server's UprightVLM now passes interpret() and ask() through (ask turns the
    picture upright first); without it every sentence the rules missed stayed 'unknown'
    - Picture questions use the whole sentence: the model shortened them ('colour')
    - interpret prompt: separate yes and no (the model copied 'yes or no' as the command),
    and describe only for general requests
    - 'how far away is the wall' is a question, not trip status
    Tested on the GX10 with qwen3-vl:30b-a3b-instruct: 14/15 phrasings read right in
    0.33-0.47 s; replaying the iPhone recording 20261010-172549 through the service on spar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
2026-10-11 Let the model place voice commands the rules cannot
    Rules stay first. A sentence they cannot place, or a request worded as a question
    ('could you point me toward the exit', which the rules sent to the picture), goes to
    vlm.interpret(), text only, which picks one of the same commands (object, place,
    describe, read, status, path, ask, yes, no, cancel). It never steers; 'path' is still
    answered from depth and 'status' by the navigator. The frame service passes it through.
    Tested on the GX10 with qwen3-vl:30b-a3b-instruct through the frame service on spare
    ports, replaying iPhone recording 20261010-172549: 5 odd phrasings placed right in
    0.38-0.47 s, each followed by the right action and speech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
2026-10-11 Status: real phone frames reached the GX10 frame service; heat fix merged
2026-10-11 Record where each IBT-2 pin physically sits, and why VCC is on 3.3 V
    The header's two rows and the screw terminal order, checked against the
    board's user guide and a photo of the team's board. Notes that the
    3.3 V choice for VCC is reasoned from the buffer chip and not yet tried.
2026-10-11 Add a thumb button to the handle's nose
    The nose now runs level for about 50 mm ahead of the pole and carries a
    panel-mount push button 34 mm from the pole axis: a 12.3 mm hole and a
    17 mm flat from the top, and a 17.5 mm nut pocket open underneath, where
    the wires come out. The handle is 141.5 mm long (was 125 mm).
    The button's size is unconfirmed: the values are for a 12 mm button,
    estimated from a photo.
    A check confirms that nothing cut for the button touches the pole
    socket. Geometric checks only; not printed.
2026-10-11 Add the electronics mount for the Pi 5 and the battery
    New hardware/electronics-mount folder: a two-piece clamp that closes
    round the tube above the motor with four M3 x 20 screws. One half
    carries the Raspberry Pi 5 on four standoffs; the other is a plain flat
    plate the battery pack is stuck to.
    Pi sizes are the published board dimensions. The battery's width is
    measured; its length and thickness are from seller listings. There is
    no place for the motor driver board.
    Geometric checks only; nothing has been printed.
2026-10-11 Push the dashboard to the browser instead of polling
    Over Tailscale each dashboard request took 0.3-1 s, and the page polled a
    picture, a depth image and the status every 0.3 s, so requests queued and
    the view ran late. Now /stream.mjpg pushes picture and depth side by side
    as one MJPEG stream (newest frame only, up to 8 fps, drawn once for all
    viewers and only while someone watches) and /events pushes the status 5
    times a second. Measured from a laptop over Tailscale: 6.3 fps on the
    page, first frame after 0.4 s, 13 KB a frame.
2026-10-11 App screen: LiDAR feed only; reconnect on return
    The screen is now the full-screen LiDAR picture with a settings gear, a status dot and the
    hold-to-talk button. Guidance shows as a glowing screen edge (pulsing red on STOP) plus
    beeps, speech and vibration. The guidance text, distance, stats and Describe/Read move
    to the GX10 dashboard; Settings still shows guidance, distance and link numbers.
    - Streaming picks up again by itself when the app comes back from the background
    - Address presets include the frame service port (:8775)
2026-10-11 Show detections with LiDAR distance and a conversation log on the dashboard
    The phone app is being cut down to the LiDAR view and the voice button, so
    the dashboard carries the rest:
    - each YOLO detection gets a distance (median LiDAR depth in the middle of
    its box) and a side (left / ahead / right in the user's frame), shown on
    its box in the stream (red under 1.5 m) and in an Objects list, nearest
    first; too few good readings shows "no depth" instead of a guess;
    - a Conversation list: what was said and what the cane answered.
    Distances come from depth only, never the model. Checked by replaying a
    recorded phone session: person 1.4 m ahead, chair 2.2 m left, etc.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
2026-10-11 Cut the phone screen down to the LiDAR view and the talk button
    Guidance state, detections with LiDAR distances, the conversation and the
    numbers are now on the GX10 dashboard (port 8000), so the phone drops the
    guidance pill, the stats chips and the Describe / Read buttons (both are
    just phrases you can say). Kept: the LiDAR view, the talk button and what
    was heard, connection settings, error and phone-heat warnings, the stop
    glow and haptic. Beeps and speech still play on the phone. One file;
    builds with Xcode 27.
2026-10-11 Dashboard: what the phone app used to show
    The iPhone app now shows only the LiDAR feed, so the dashboard takes over its overlay:
    - guidance banner tinted by state with the sentence spoken; the server keeps the last
    sentence for 10 s because speech is on one frame and the page samples 5 times a second
    (the old 'Says:' line usually missed it)
    - reticle and distance at the centre of the depth picture, and centre_m in the status
    - red edge on STOP; Describe, Read, Status and Stop buttons
    - 'Heard': the last voice command and whether the rules or the model placed it
    (navigator.heard, status 'heard')
    - the wheel command panel is labelled 'Wheel:' so it is not read as a second state
    Tested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
2026-10-11 LiDAR view in the usual Turbo depth colours
    Near orange, then yellow, green, cyan and blue, far deep purple, like a regular LiDAR
    depth view (and the dashboard's depth picture). Missing readings take the far colour
    instead of black, low-confidence pixels are no longer darkened, and the picture is
    scaled smoothly. A 256-entry lookup table keeps it cheap.
2026-10-11 Put the app's layout back; keep the Turbo colours
    The previous commit removed the guidance banner, reticle, distance, stat chips and the
    Describe/Read dock; the layout was meant to stay. Restored as it was before 29a932c.
    Kept, as they do not change the layout: Turbo colours in the LiDAR window (smoothly
    scaled), reconnecting on return from the background, and :8775 in the presets.
2026-10-11 Record the wire colours used between the Pi and the IBT-2
    Read from photos of the Pi's header. Black is on 3.3 V and yellow on ground, so the table says so plainly.
2026-10-11 Decode each phone picture once and stream the dashboard at 15 fps
    The frame service decoded the JPEG, turned it, re-encoded it, then YOLO
    decoded it again, and the dashboard a third time. Now it is decoded and
    turned once (ingest/upright.decode_upright), and YOLO (detect_image) and
    the dashboard share the image. Per frame on 110 recorded phone frames:
    9.6 ms -> 9.2 ms; the GX10 is not what limits the frame rate.
    Dashboard stream: 15 fps cap (was 8), 400 px high, JPEG 60. Measured from
    a laptop over Tailscale with recorded frames: 13.9 fps (was 6.3).
2026-10-11 Dashboard text: the stream now runs at up to 15 frames a second
2026-10-11 Write up the cane's wiring in full, with diagrams
    - hardware/wiring.md: status of each part of the wiring, parts list,
    power, the six Pi-to-driver wires with their real colours, the
    driver's header layout, the limit switches, the wiring order, a check
    list for before the first power-on, the first tests to run from the
    Pi, and what to look at when something is wrong.
    - hardware/diagrams/: three diagrams (the whole cane, the six wires on
    the real boards, every pin on the Pi's header) and the script that
    draws them from one table of pins and colours.
    - AGENTS.md, hardware/README.md, docs/PROJECT_HISTORY.md: the wiring's
    current state.
    The diagram tables were checked against pi/ha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
2026-10-11 Fix three steps in the wiring guide that could not be followed safely
    Found by a review of the guide and checked against the code:
    - The polarity check came after the driver was already connected. It now
    happens at the bare adapter, before anything else is wired to it.
    - "Start with the battery unplugged from the driver" is not possible
    while one barrel plug feeds both the Pi and the driver. The first
    tests now say to run the Pi from its own supply until the kill switch
    is fitted.
    - The motor moves as soon as cane.py starts, before anything is typed.
    The guide now says so, and says what happens with no limit switches.
    Also corrects the note about what the diagram script's tables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
2026-10-11 Add a start-up bench test that ramps the motor to full power
    spin_test.py ramps the motor from stopped to full power over 10 seconds,
    holds for 2 seconds and switches off. sightsense-spin-test.service runs
    it once when the Pi has been on for 15 seconds, so the motor can be seen
    turning without logging in.
    It is for the bench only: it goes past the controller's 25% power cap
    and 0.4 second limit, so the motor must be free to turn. It does not
    start, and stops at once, if a limit switch is pressed. Deleting
    spin-test-enabled from the boot partition switches it off.
    Tested on gpiozero's mock pins (6 new tests, 36 in all). Not yet run on
    the Pi or with the motor.
2026-10-11 Stop the bench test after three runs in a row that do not finish
    If the motor starting makes the Pi lose power and restart, the start-up test would otherwise run again on every restart. It now counts runs that started and did not finish, and refuses after three.
2026-10-11 Apply the rest of the wiring-guide review
    Confirmed by a second reader in each case:
    - Power no longer goes on in the wiring order, one section before the
    checks that must be done with everything unplugged.
    - The Pi only holds the driver off while cane.py is running. The first
    tests now say to watch the shaft before and after each test and to
    keep the 12 V off whenever no program is running.
    Smaller corrections: which driver pins to look at for black and yellow,
    the fuse and limit switches drawn as not fitted, the stop to use while
    there is no kill switch, and two lines in AGENTS.md that contradicted
    the rest of the file.
2026-10-11 Let the Pi follow the GX10 frame service, with or without limit switches
    The GX10's frame service already sends the Pi one command per frame, and
    the controller already follows that format. This adds what was missing
    to use the two together:
    - pi/test_with_gx10.py runs the GX10's real pipeline (depth obstacle
    check, navigator, smoothing) on its fake phone's frames and feeds the
    commands into the steering rules on the simulated wheel.
    - --open-loop, for a cane with no limit switches: the position is worked
    out from how long the motor has run. The power cap, the move limit and
    the silence rule are unchanged.
    - sightsense-cane.service starts the controller when the Pi starts, with
    th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
2026-10-11 Make the bench test and the controller stop the motor in more cases
    From a review of the start-up motor test:
    - A closed terminal (SIGHUP) or Ctrl+\ now switches the motor off, in
    spin_test.py and in cane.py. Ctrl+Z is ignored in the bench test, as
    it would freeze the program with the motor on.
    - On the way out the bench test switches the enables off first, and one
    failed step no longer skips the rest.
    - The bench test's service now counts as done once it has run, so
    starting the target again in the same boot does not repeat the ramp.
    - The README says how to see why the motor did not turn, and that the
    Pi is not holding the driver off once the test ends.
    45 tests pass on a lapto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
2026-10-11 Record the result of the driver-end photo check in the wiring guide
    Five independent readings of the photos placed all six wires on their planned driver pins. The rows are worked out from the camera angle, not seen, so the eye check before power stays. Adds a meter check that uses the screw terminal, for when the housings cover the pins.
2026-10-11 Skip a frame's picture when it is empty instead of crashing
    OpenCV raises on empty bytes rather than returning None, so a frame
    with no JPEG stopped the pipeline. Found by Connor's test_with_gx10
    on pi-on-integration, which now passes against this branch.
2026-10-11 Redesign the iPhone screen: guidance card with a distance bar, readouts on the LiDAR view, floating controls
    Same pieces as before, rearranged: state icon and spoken sentence in one card with a
    parking-sensor style bar (zones at the GX10's 1.2 m and 2.5 m), depth size, tracking,
    send delay and heat shown on the LiDAR picture with a Turbo colour key, a new
    connect card, and rings on the talk button while listening. Animations run only on change.
2026-10-11 Obstacle check: usable from 1.5 m instead of 2.5 m, stop answer under 0.8 m
    On October 10 the cane stopped about 2.2 m from things, which the team found too
    cautious: the phone and wheel are at the cane, already ahead of the user. Tests now
    build their scenes from USABLE_M, and a wall 2.5 m ahead no longer stops.
2026-10-11 App logo and icon, distance bar on the new 0.8 m and 1.5 m zones
    LogoMark.swift draws the logo (a cane whose tip sends out rings in the LiDAR colours);
    tools/render_icon.swift draws the 1024 px app icon from it. Shown on the top bar and the
    connect screen. The distance bar follows the GX10's lowered distances, with labels at
    their true place on the bar.
2026-10-11 Resize the handle's button mount for the 7 mm mini push button
    The team's button is a 7 mm prewired mini push button (PBS-110 type),
    not the 12 mm one the handle was sized for. Its body sits under the
    plastic and its nut goes on from the top, so the mount is reworked:
    a 7.5 mm hole through 2.5 mm of plastic, a 14 mm flat for the nut and
    a 13 mm pocket for the body.
    The pole socket is too close under the nose for the switch to come up
    from below, so the nose is open at the front through a 10.8 mm slot.
    A check confirms the switch can slide in and lift into place without
    touching the handle or the socket.
    Only the 7 mm thread is confirmed, from the seller's listing; the
    other switch sizes ar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
2026-10-11 Obstacle check: steer to the most open heading in tight spaces instead of stopping
    Looking at the pictures from the October 10 evening walk (indoors, 15 min), most stops
    had a gap to walk through: nothing was open to 1.5 m, but one side was open past a metre.
    Now STOP only when every heading is blocked within 0.8 m; once stopped, going again needs
    1.0 m, so it does not flip in and out. Replayed on that walk: STOP 51% -> 28% of the time,
    the same number of stop beeps (19), and what still stopped was about 0.3 m away.
2026-10-11 Steady detections, and YOLOE for hazards YOLO cannot name
    YOLO judged each frame on its own, so objects near the confidence line
    blinked on and off, and it has no name for doors, stairs or poles.
    - detector/stable.py follows each object across frames: shown after 3
    of 5 frames, kept through a missed frame, hidden after 4 of 5 missed.
    Label changes per frame on recordings: 0.38 -> 0.12 and 0.75 -> 0.13.
    - YOLOE-26s looks for door, stairs, pole, pillar, curb, railing, trash
    can, traffic cone and sign; the prompts are built once and saved.
    - Both models in half precision: 7.7 ms a frame for the two together,
    same objects as full precision.
    - Dashboard draws hazards in violet.
    Neither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
2026-10-11 Add direct wheel drive and a verified Pi SD updater
2026-10-11 Add motor mount 2, a sturdier version of the v4 motor receiver
    It takes the same v4 main insert and cross bolt. A sleeve goes 20 mm over
    the end of the tube, the receiver body is 22 mm across, and two side walls
    and a back plate hold the gearbox along its whole length.
    Not printed or load tested. Motor sizes are from a published drawing.
2026-10-11 Hold the Pi with M2.5 screws and nuts on the electronics mount
    The holes through the standoffs and the plate are now 2.8 mm right
    through, for M2.5 x 12 screws with a nut on the inside, in place of
    2.2 mm pilot holes for self-tapping screws. The Pi sits 8 mm higher on
    the plate so all four nuts clear the clamp bars. The battery half is
    unchanged.
2026-10-11 Dashboard: steer the Pi's motor by hand
    A "Steer by hand" panel sends LEFT, CENTER, RIGHT, STOP or FREE to the
    Pi with the existing command message; no contract change.
    - Hold a direction to drive (buttons or arrow keys); letting go stops.
    - Depth still wins: while phone frames arrive and the obstacle check
    says STOP, a manual turn or CENTER is sent as STOP.
    - The page re-sends about 7 times a second; if it goes quiet for 1 s
    (tab closed, link lost) the wheel goes back to automatic.
    - Sent to the Pi 10 times a second with the usual 400 ms TTL, so the
    Pi's own watchdog still switches the motor off if the GX10 stops.
2026-10-11 Dashboard: Raspberry Pi temperature and power, and an Ask Qwen button
    - The command port now reads what the Pi sends back: a health report
    every 2 s ({"health": {...}}, from the pi-health branch). Status
    carries it while it is under 6 s old.
    - New "Raspberry Pi" panel: CPU temperature, 5 V input and any dips,
    throttling, load and Wi-Fi, motor mode and power, uptime. There is
    no battery gauge, so the input voltage stands in for battery level.
    - "Ask Qwen" button in the voice panel; a placeholder until it is
    wired to the model.
    The health message is not yet in contracts/MESSAGES.md; that needs
    the team's go-ahead. Nothing steers from it.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
2026-10-11 Pi: send temperature, input voltage and settings to the GX10
    Every 2 s on the existing command connection the Pi sends
    {"health": {...}}: CPU temperature, 5 V input (vcgencmd pmic_read_adc),
    undervoltage and throttling flags, load, Wi-Fi signal, uptime, and its
    own motor settings (mode, duty, cap, rated rpm, swap).
    It runs as its own task beside the command reader. A failed reading is
    left out, a failed send ends the reporter quietly, and nothing in it
    touches the motor. Standard library only.
    Tested: test_health (5 tests); the full Pi suite passes on a Mac;
    cane.py --sim --wheel-drive against a GX10 test server delivered the
    report to the dashboard status and followed a manual LEFT, then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
2026-10-11 Add an interactive 3D assembly of the whole cane
    One self-contained HTML page with every printed part in place: handle,
    phone mount, main insert, motor mount 2, wheel adapter and cap, and the
    battery and Raspberry Pi mount. The tube length, the wheel and the phone
    are stand-ins, as the README says.
    viewer.py gains triangles() and encode() so the assembly can reuse its
    meshing; viewer.html is unchanged.
2026-10-11 Tell the user which way to go, only when it changes, instead of beeping CAUTION/STOP
    New planner/cue.py turns the smoothed wheel command into a direction for the phone
    (LEFT, STRAIGHT, RIGHT, STOP, UNKNOWN): "Bear left" / "Bear right" with a tone for
    that ear once, silence for straight, one stop tone per stop, at most one spoken
    direction every 2 s. The stop beep no longer comes with every frame. Guidance messages
    get an optional direction field (contracts/MESSAGES.md, agreed with the team lead).
    Dashboard shows the direction. Replayed on the October 10 walk at 17:25: 36 beeps a
    minute before, 6 sounds a minute now.
2026-10-11 Add a talk button on the Pi and show how to wire it
    A momentary push button in the handle, between GPIO17 (header pin 11) and ground (pin 9). The controller tells the GX10 when it goes down and up, beside the health reports, so the phone can be told to listen. The Pi does no listening and the button code cannot reach the motor.
    Adds the two messages to the contract, a wiring section and diagram, and a wiring check (cane.py --bench button). Tested on mock pins and a stand-in link only: no real button has been fitted.
    Also lets the health report run where the system has no load average, so the Pi tests pass on Windows.
2026-10-11 Add the wheel adapter's interactive 3D viewer
    One self-contained HTML page showing the adapter, the cap, the motor
    shaft and the screws, with the script that rebuilds it.
2026-10-11 Draw the assembly with four 400 mm tubes and their couplers
    The pole in the whole-cane viewer was one 900 mm stand-in tube. It is now the team's four 400 mm tubes meeting end to end, with a v3 main insert and a v3 receiver at each of the three joints. The script checks that each tongue seats and that both inserts sit inside their tubes.
    At this length and the 30 degree lean the handle is drawn for, the model puts the top of the pole 1.51 m above the ground. The README says so, with the figures for three and two tubes.
    The viewer page and its two pictures are regenerated. Nothing here has been printed or fitted.
2026-10-11 Pass the cane's talk button on to the phone
    The Pi reports the talk button in the handle going down and up. Down tells the phone to listen. Up tells it to stop only after a hold of 0.6 s or more; after a click the phone stops by itself. What the phone hears comes back as an ordinary voice message, so nothing else in the service changes.
    Adds the two messages to the contract (the same text as on the Pi branch). Tested with stand-ins for the Pi and the phone, and with the Pi's real link code over local WebSockets. Not tried with the real button or phone.
2026-10-11 Let the cane's talk button start and stop the phone's listening
    The GX10 passes the cane's talk button on as {"listen": true} or {"listen": false}. True plays a short tone and starts the same speech recognition as the button on the screen; false stops it and sends what was heard. After a click the phone stops by itself, 1.5 s after the last new word or after 8 s of nothing. While it is listening it does not speak, except for a stop.
    Not compiled: written on a Windows laptop with no Xcode. Build it and try both talk buttons before relying on it.
2026-10-11 Widen the M3 hole in the v4 tongue and add fit tests for motor mount 2
    The cross-bolt hole through the v4 tongue and receiver was 3.2 mm. The wheel adapter's first test print showed M3 screws do not pass 3.2 mm holes, and motor mount 2's matching hole is already 3.6 mm, so the tongue would have stopped the bolt. It is now 3.6 mm in both v4 parts.
    Motor mount 2 is about a six-hour print and its sleeve, socket and gearbox pocket are all unconfirmed fits, so two slices of it are exported as fit-test pieces: the top of the mount for the tube, tongue and bolt, and the band round the gearbox for the motor and its two screws.
    The notes also say how level the insert must be glued for the bolt to l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
2026-10-11 Add a joint sleeve that takes the bending at each tube joint
    At a joint the tubes only butt end to end, so the coupler's 10 x 8.5 mm printed tongue carries all the bending. Carrying a four-tube cane level by its handle is estimated to put 8 to 12 N.m on the top joint from the cane's own weight, and the tongue is estimated to break at 2 to 7 N.m.
    The sleeve is the camera collar's clamp made longer: a split ring with three M3 screws that covers 30 mm of each tube, where the glued-in inserts back the wall. Its ring section carries about 16 times the bending of the tongue's for the same stress.
    The figures are estimates from the model and typical material values. Checked with geometric checks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
2026-10-11 Bring the Pi's two GX10 tests up to date with the obstacle check
    The obstacle check now counts a heading usable from 1.5 m and stops for a wall inside 0.8 m, steering to the most open heading before that. Walking at a wall it sends CENTER, RIGHT, CENTER, then STOP at 0.77 m, where it used to send LEFT and stop at 2.3 m.
    The two Pi tests that run the GX10's real pipeline still expected the old sequence. They now check that it goes straight while the wall is far, that every command with the wall inside 0.6 m is STOP, and that whichever way the check turns reaches the Pi's motor.
2026-10-11 Add a test that runs the whole cane on one computer
    The GX10's real frame service and dashboard, and the Pi's real controller in direct wheel mode, joined by real WebSockets and HTTP. The phone, the motor pins, the talk button and the vision model are stood in for.
    It walks the fake phone at a wall and checks the guidance, the Pi's motor pins and the 25% cap, that every pin is off 0.6 s after frames stop, the Pi's health on the dashboard, a depth answer, a picture question, a place lookup with a route and a yes, the talk button as a click and as a hold, and manual steering from the dashboard and back.
2026-10-11 Give the fake phone a real picture when the test image is missing
    The fake walk put an empty picture in every frame unless vlm/test_images/empty_room.jpg had been made, and that folder is not in the repository. The app's own frame checker rejected all 120 frames as 'picture is not a JPEG', and the navigator skips picture questions on a frame with no picture, so 'what's in front of me' did nothing in a fake session.
    It now falls back to a plain grey JPEG. The app's checker then passes 120 of 120 frames from the GX10's fake phone, which also confirms the two sides agree on the rest of the frame format. The whole-system test uses the walk's own frame for its voice checks and no longer needs Pi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
2026-10-11 Make the fake GX10 read what the Pi sends
    The Pi now sends a health report every 2 seconds and the talk button on its command link. The fake GX10 only sent and never read, so after 17 unread messages the link stopped answering the Pi's keepalive and the Pi dropped it about every 38 seconds, switching the motor off each time. Anyone bench-testing the wheel against the fake would have seen it cut out.
    It now reads the link and prints talk-button messages. A new test sends two minutes' worth of health reports at once and checks the link still answers; it failed before this change.
2026-10-11 Give the phone tones for left, right and unknown, and space out repeated directions
    The GX10 now sends the sounds 'left', 'right' and 'unknown' with its direction cues, but the phone only had 'stop', 'caution' and 'other', so all three played the same short blip as the talk-button tone. The phone gets a low tone for left, a high one for right and a long low one for unknown, panned to that ear. The Swift change has not been compiled.
    The GX10 repeated a direction after exactly 4.0 s and the phone refuses the same sentence within 4.0 s, so with network jitter the repeat was sometimes dropped. The GX10 now waits 4.5 s, for direction cues and for route turns.
2026-10-11 Make the plug inside the handle's tube socket a separate printed part
    Printed in one piece with the handle lying on its side, the plug hung over a 1.3 mm gap along the whole 43 mm socket, so the slot for the tube wall would fill with support or sag shut. The handle now has a plain bore, and a 15.7 x 43 mm plug is printed standing up and glued into the top of the tube. Geometric checks only; nothing printed.
2026-10-11 Keep the frame service up through bad messages, a busy dashboard and a missing model
    A text message that is not a JSON object, or a route with the wrong types, ended the phone's link and left the dashboard showing it connected. Manual steering read its state several times while the dashboard's thread could clear it. The status count walked a list the frame thread was adding to. The service refused to start when Ollama was not running, although the obstacle check does not need it. The clearance bars used the old 2.5 m and 1.2 m limits.
    Tests in ingest/test_bad_text.py fail before and pass after. Run on a laptop; not on the GX10.
2026-10-11 Stop a quick second click of the talk button losing the command
    A start inside the 0.4 s after a stop was cancelled by that stop's own clean-up, and the first command was never sent. A click just after the phone had stopped by itself opened a second 8 s of listening, during which the GX10's answer was not spoken. Not compiled: written on a laptop with no Xcode.
2026-10-11 Bring the notes in line with the code: ports, Tailscale, health message, obstacle limits
    The app's presets use port 8775 and the Pi 8766; the GX10 notes now give the one start command that serves both. The contract and the disclosure said every link stays on the team's router; the devices use Tailscale. The Pi's health message was not in the contract. AGENTS.md still had the 2.5 m and 1.2 m limits and listed parts as not designed that now are. cane.py's usage lines started the old position mode.
2026-10-11 Answer spoken questions during guidance, and end a place lookup that finds nothing
    A question asked while the object guide's find was running came back as I couldn't tell; it now waits up to 3 s for the model. A place lookup with no result left the navigator looking it up for good, and a route that arrived after stop was still offered. On a route with weak GPS or no compass heading, am I going the right way answered yes. Voice text with a curly apostrophe missed the rules. Is the path clear called the end of the depth range something 4.5 metres ahead while steering to one side.
    Each has a test that fails before and passes after. Run on a laptop with the model stubbed; not on the GX10.
2026-10-11 Keep the cane's phone when a test client leaves, and stop the phone speaking into its own microphone
    GX10: when a second client left the phone port the service forgot the first, so the talk button told nobody. The fake phone's replay timed each reply against the wrong frame unless the recording began at frame 1.
    App, not compiled: while the user is talking nothing is spoken, the stop sentence included; tones still play. A command started by a click ends about 12 s after it began even if words keep arriving. A click after a listen that heard nothing starts a new one.
2026-10-11 Say within reach before the obstacle stop, and no stop tone when a session starts on open floor
    Reach was 0.8 m, the same as the obstacle stop, so an object on a table was never reached: the edge of the table stopped the cane first and it went on to say Path blocked. Reach is now 1.2 m, a number to try on the real cane.
    The obstacle smoother begins every session and every gap over 1 s in STOP for two frames, and the phone got a stop tone for it with nothing in the way. The tone is now held back unless that frame's depth says stop or the object is reached, so a wall on the first frame still sounds at once.
    Tests fail before and pass after. Run on a laptop with the model stubbed; not on the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
2026-10-11 Fix what a second read of this morning's changes found
    App, not compiled: after 8 s with nothing heard, a click in the next 0.4 s played the tone but did not listen. Notes: the test copy of the service must switch its dashboard off beside the live one; two app address examples still pointed at port 8765; the 2 s click rule applies only when something was heard; the handle has four printed parts and a 45 mm socket; the whole-cane model has no joint sleeves; the Pi is set up for Tailscale but its link to the GX10 is not recorded on this branch.
2026-10-11 Check what the obstacle check makes of the ground, and let it ignore the cane's own lower end
    On ray-cast scenes with depth noise, a level floor was never taken for an obstacle in 504 poses. The phone has to look at least 25 degrees below the horizon or open space reads as unknown and the cane stops. Ground falling away reads as blocked, which is left as it is. Tests repeat the main cases.
    New setting SIGHTSENSE_OWN_CANE_M, off by default, ignores a narrow strip straight ahead where the cane's own motor, wheel and Pi clamp can show in the picture. The dashboard shows how far the floor is below the phone. Run on a laptop; not on the phone or the cane.
2026-10-11 Answer help, say that again and the time, and show talk button presses on the dashboard
    What can you do, say that again and what time is it are answered at once without the model. Each press of the cane's talk button adds a line to the dashboard's conversation, so the button can be checked without the phone. The whole-system test now presses the button and asks two questions.
    Also from the last review: a nothing-found answer to an earlier place lookup ended a newer one; No compass heading was marked as said when another sentence took its place; one test no longer covered its try/except and another failed on a busy computer. Run on a laptop with the model stubbed.
2026-10-11 Record a live check of describe, read and questions on the GX10, and keep the script
    At 9:25 AM on October 11 a stand-in phone on a laptop sent the service running on the GX10 a drawn test picture over Tailscale, with frames that can only read STOP. Describe answered in 0.95 s, read in 0.30 s, a question about the picture in 0.48 s, the path question from depth in 0.27 s. The service there was older code than this branch.
    Every Swift file parses with a Swift grammar, which checks syntax only. The app has still not been compiled.
2026-10-11 Add a sound check, a tap for left and right, and tests that the cane steers round things
    Sound check, by voice or typed, makes the GX10 send the phone each tone with its name spoken. The app gets a Test sounds and speech button that needs no GX10, and a light or heavy tap for left or right (not compiled; the Swift parses with a grammar).
    A simulated walker that follows the wheel gets round a box, through doorways and along a corridor without a stop, and someone who ignores the wheel is stopped about 0.75 m from a wall. The live-check script can now wait for a second answer. Run on a laptop.
2026-10-11 Let the Pi SD update install further Wi-Fi profiles as fallbacks
    The installer put one staged profile in one fixed place, so installing a new network replaced the old one. Further profiles (--more-wifi-profile, repeatable) are now staged as wifi-2, wifi-3 and installed beside the first; NetworkManager chooses by each profile's autoconnect-priority. Staging a card a second time no longer repeats the motor-pin lines in config.txt.
    Tests on temporary folders, and the installer's new loop dry-run in a temporary folder. Not yet run on the Pi. No Wi-Fi name or password is in the repository.
2026-10-11 Record that the Pi's SD card was staged with the hackathon Wi-Fi and the talk button code
    Staged on the laptop on October 11 at 10:31 AM from 18f5b35, with three Wi-Fi profiles in order of preference and the old network kept as a fallback. Read back and checksummed on the card. Not yet booted in the Pi.
2026-10-11 Dashboard obstacle view: what the LiDAR check sees, and why it turns
    The right-hand panel of the live stream now shows the obstacle check
    pixel by pixel instead of plain depth: floor green, obstacles red under
    1.2 m, amber under 2.5 m, yellow beyond, too close magenta, no reading
    dark blue (both blocked). Lines split the seven headings, each labelled
    with its clearance. The side the wheel turns to, or the side held in
    manual steering, stays bright with its corridor's obstacles outlined,
    and a banner says why ("<< LEFT (manual) -30: 0.8m -20: 0.8m - blocked").
    The same line is shown under the picture.
    check(want_maps=True) returns the per-pixel maps it already had; the
    decision does not use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
2026-10-11 Dashboard: spin the motor counter-clockwise or clockwise by hand, no positions
    The Pi's direct-drive mode (--wheel-drive) spins the motor one way for LEFT and the
    other for RIGHT, and switches it off for STOP; there are no left, centre or right
    positions. The manual panel now has two hold buttons, Counter-clockwise (LEFT) and
    Clockwise (RIGHT); letting go sends STOP. CENTER and FREE are no longer accepted
    from the dashboard. Free space is not checked while someone controls it by hand:
    an obstacle STOP is shown on the dashboard but not applied. No message format change.
2026-10-11 iPhone app: fix "unable to type-check this expression in reasonable time"
    ContentView's body failed to compile with Xcode 27 on a Mac here
    (ContentView.swift:72). The cane talk-button handler and the left/right
    tap ternary now live in two small static functions with explicit
    types; what they do is unchanged.
    Tested: xcodebuild for generic iOS, signed with a free Apple ID,
    BUILD SUCCEEDED (failed before this change).
2026-10-11 Record what was seen live on the cane at 10:42 and 10:57 AM on October 11
    The staged card booted, the Pi joined the hackathon Wi-Fi and connected to the GX10, and its tests passed on the Pi. With the real phone streaming, the GX10 on this code sent STOP, CENTER, LEFT and STOP as the view changed, the Pi logged real talk button presses and a wheel command at 25%, and the dashboard showed each press. Watched from a laptop; what the motor did and whether the phone listened were not seen.
2026-10-11 Voice: sensible answers from Qwen, and a mock test that measures them
    Live on the cane, "hello" got a trip status, "the computer near my
    right" was looked for by that whole name, answers said "in the image"
    and "ahead of the camera", object lists had no order and repeats, and
    "read the sign" read a jacket logo and made words from blurry letters.
    - Rules: greetings, thanks and small talk answered at once; filler and
    a stray letter from speech recognition ("jwhat") ignored; "can you /
    tell me ..." unwrapped; "where am I going" is status; "what objects
    are here" lists things; where a thing is ("on the left", "over
    there", "on the table") is a side hint, not part of its name.
    - Object g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
2026-10-11 Speech: one sentence at a time, most important first
    The obstacle check, direction cues, object guide and answers each spoke
    on whatever frame they liked. Sentences a few frames apart queued on
    the phone, and in STOP each new one cut the last off half way.
    planner/speech.py (SpeechPlan) now decides what is said and when:
    - priorities SAFETY > ANSWER > GUIDE > INFO; one sentence per frame,
    only once the phone should have finished the last (estimated from
    its words, 2.6 a second at the app's rate) plus 0.6 s
    - a spoken stop cuts into a direction or hint, but waits for an answer
    the user asked for (the stop tone and the wheel have already acted);
    not repeated within 10 s
    - directions a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
2026-10-11 Dashboard: new look, same functions
    Bento grid of glass cards, dot-pattern background with a glow in the guidance colour,
    a border glow that follows the pointer, a light travelling round the guidance banner,
    an arrow or hand icon for the direction, numbers that count to new values, and new
    conversation and object rows sliding in. Patterns from 21st.dev / Magic UI / Aceternity,
    redone in plain CSS and JS in this file: no new dependencies and nothing loaded from
    the internet. Every element the script updates, every button and the manual spin
    controls are unchanged. Animations are off when the computer asks for reduced motion.
2026-10-11 Obstacles in words, warnings before answers, and depth out to 10 m
    - planner/obstacle_talk.py: the obstacle check in words, naming the
    thing from the detectors when it is straight ahead: "Stop. Chair
    ahead, about 1 metre. Open to your left.", "Laptop ahead. Bear right
    around it.", "You're past it. Carry on." Distances from the LiDAR.
    The wheel is unchanged.
    - planner/speech.py: a spoken stop now cuts into anything, and an
    answer it cuts off early is said again after it ("As I was saying:
    ..."). While something is within 1.5 m, "Careful: chair ahead, about
    1 metre." goes before the next answer, at most every 20 s.
    - FAR_M 4.5 -> 10 m (SIGHTSENSE_FAR_M). ARKit reports 5-8 m at me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
2026-10-11 Dashboard: plain, professional look
    Flat grey cards, one muted blue for actions, and colour only where it means
    something (guidance state, warnings). Removed the glowing background, pointer
    glow, travelling border light, shimmer and glow shadows. Same elements, buttons,
    manual controls and data as before.
2026-10-11 Turn away from what is close: fix left and right near obstacles
    Near an obstacle the cane often said to turn towards it. Checked on real
    recordings, the sensing is the right way round: LiDAR wedges, object
    bearings and turning all match the upright picture (1157/1157,
    1465/1468, 232/234 frames; planner/check_directions.py). The fault was
    the decision: something under about 0.6 m sits in all seven paths at
    once (they start together at the phone), so every clearance read the
    same and the side to turn to after a stop was a coin toss (50% right on
    the 11 October cane session).
    - check() also gives near_side (which side most obstacle points within
    1.2 m are on) and room (median distance of the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
2026-10-13 Add a bill of materials for the cane
    Collects the electronics, tubes, printed parts, screws and nuts from the
    hardware pages into hardware/BOM.md, with the page each line comes from.
    No prices or shop links: the team's orders are not recorded here.
2026-10-13 Bring the docs up to date after the event
    - Point the README, docs index, hardware pages and AGENTS.md at the bill
    of materials and at the 3D model page on GitHub Pages.
    - Record the wheel as 85 mm, from the seller's listing, and say which
    drawings still assume about 58 mm.
    - Mark the talk button as wired, as pi/README.md records.
    - Add the after-the-event entry to the project history and the model
    page to the disclosure.
2026-10-13 Remove the fuse and kill switch from the bill of materials
    Neither is fitted on the cane. wiring.md still describes them as planned.
2026-10-13 Re-render the README's 3D pictures from the current model
    The model has changed since they were made: the fuse is gone and the
    talk button's two leads now run down the pole to the Pi.
2026-10-13 Add photos of the cane to the README
    Four photos the team took at the event: the whole cane in hand, the
    wheel end on the floor, the electronics up close, and the battery and
    wheel from above.
2026-10-13 Re-render the README's 3D pictures: red and black button wires
    The talk button's two leads in the model are now red and black.
